srlm-io/anzhelka/hardware/pcb/QuadPower/Current/README.txt

Current:
Fixed ground plane.

To be completed:
Test REV A for other unseen problems.

REV A:
First version of the board to be approved to be milled.

Things to be fixed in:
Forget to put down a ground plane.
Forgot current limiting resistor on the DOUT pin of the MCP3208.
