srlm-io/anzhelka/doc/reports/179J_Report/quadrotor_report.tex

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

% NOTES: 
% --- Titles overlap for Engineering Effort and Societal Impacts.

% TODO: Additional material
% --- System design could be expanded (but not absolutely necessary

\documentclass{article}

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

\definecolor{lightlightgray}{gray}{0.9}

\graphicspath{{../tests/}{../figures/}{../extra/}} %\graphicspath{{path/one/}{path/two/}{path/three/}}

\fancyfoot[CO,CE]{ \thepage \\ }
\pagestyle{fancy}

\begin{document}

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

%% REV REV REV REV REV REV REV REV REV REV REV REV REV

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

%% S1 S1 S1 S1 S1 S1 S1 S1 S1 S1 S1 S1 S1 S1 S1 S1 S1 S1 S1 S1  

%% S1 S1 S1 S1 S1 S1 S1 S1 S1 S1 S1 S1 S1 S1 S1 S1 S1 S1 S1 S1  

%% S1 S1 S1 S1 S1 S1 S1 S1 S1 S1 S1 S1 S1 S1 S1 S1 S1 S1 S1 S1  
\section{Introduction}

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

%% S2 S2 S2 S2 S2 S2 S2 S2 S2 S2 S2 S2 S2 S2 S2 S2 S2 S2 S2 S2
\subsection{Executive Summary}
\begin{figure}[h!]
  \centering
	
  \caption{Rendering of the Open Source Elev-8 quadrotor platform used in the Anzhelka project (image courtesy of Parallax).}
\end{figure}  

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

Hardware on the other hand is a bit more difficult. Only one team member has any experience with designing PCBs and circuits, but not nothing to the extent of this project. We believe that, based on the work we have put into the project, that we have earned the class credits that we are receiving. Approximately 30 hours per person per week were devoted to this project(terminal program).
%% S2 S2 S2 S2 S2 S2 S2 S2 S2 S2 S2 S2 S2 S2 S2 S2 S2 S2 S2 S2

%% S2 S2 S2 S2 S2 S2 S2 S2 S2 S2 S2 S2 S2 S2 S2 S2 S2 S2 S2 S2  
\subsection{Design Objectives and System Overview}

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

\subsection{Current Project Status}
As of this writing, we still have work to do in order to achieve stable autonomous hover. We are in the process of testing the thrust torque test stand, and verifying all electrical circuits on the quadrotor. Once that is complete we will be able to write the three control loop blocks, as described in detail in the Anzhelka mathematics document \cite{anzhelka_math}. It is estimated that these blocks will be able to run at up to 300Hz (section \ref{subsec:codeperformanceestimation}).  For the project schedule, see subsection \ref{subsec:maintenance_plan_10}.

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

The project uses the following directory structure:
\begin{lstlisting}
 /hardware 
    /frame 
    /pcb 
 /software 
    /spin 
       /src 
       /lib 
       /test 
       /tool 
       /config 
    /java 
       /src 
       /lib 
       /test 
       /tool 
       /config 
 /doc 
    /datasheet 
    /reports 
    /figures 
    /notes 
    /tests 
    /extra 
 /extra 
\end{lstlisting} 

\texttt{hardware}:
Subfolders will store the major components of the project. For example, the frame has several .dxf files that are sent to the laser cutter, so that will all go into a subfolder called \texttt{frame}. The project may have several PCBs made as well, and so each should go into a subfolder under \texttt{pcb}. 

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

%\clearpage %make room for the picture

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

%%TODO: update the file path typesetting.

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

%% S1 S1 S1 S1 S1 S1 S1 S1 S1 S1 S1 S1 S1 S1 S1 S1 S1 S1 S1 S1  
\section{Requirements Specifications}
In this section we define the various requirements of the quadrotor platform. The quadrotor must be able to achieve various goals, and since it is a hard real time system the goals must be achieved by a specified deadline.
%% S1 S1 S1 S1 S1 S1 S1 S1 S1 S1 S1 S1 S1 S1 S1 S1 S1 S1 S1 S1  

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

%% S2 S2 S2 S2 S2 S2 S2 S2 S2 S2 S2 S2 S2 S2 S2 S2 S2 S2 S2 S2  

%% S2 S2 S2 S2 S2 S2 S2 S2 S2 S2 S2 S2 S2 S2 S2 S2 S2 S2 S2 S2  
\subsection{System Environment and External Interfaces}

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

%% S2 S2 S2 S2 S2 S2 S2 S2 S2 S2 S2 S2 S2 S2 S2 S2 S2 S2 S2 S2

%% S2 S2 S2 S2 S2 S2 S2 S2 S2 S2 S2 S2 S2 S2 S2 S2 S2 S2 S2 S2  
\subsection{Safety}

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

%clearpage %make room for the picture
%% S1 S1 S1 S1 S1 S1 S1 S1 S1 S1 S1 S1 S1 S1 S1 S1 S1 S1 S1 S1  
\section{System Design}
The system is fairly simple. The general system architecture consists of the central Propeller microcontroller interfacing with a number of different devices. Both hardware and software mimic this layout, which is shown below.

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

%% S1 S1 S1 S1 S1 S1 S1 S1 S1 S1 S1 S1 S1 S1 S1 S1 S1 S1 S1 S1

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

%% S1 S1 S1 S1 S1 S1 S1 S1 S1 S1 S1 S1 S1 S1 S1 S1 S1 S1 S1 S1  
\section{Software Introduction}
This section describes the quadrotor software environment.
%% S2 S2 S2 S2 S2 S2 S2 S2 S2 S2 S2 S2 S2 S2 S2 S2 S2 S2 S2 S2  
\subsection{Propeller}
For this project we selected the Parallax Propeller as our main embedded processor. This chip has several unique features that make it well suited to the real time requirments of quadrotoor flight. The Propeller is relatively inexpensive as well: \$8 per chip, plus approximately \$2 for support components.

%% S3 S3 S3 S3 S3 S3 S3 S3 S3 S3 S3 S3 S3 S3 S3 S3 S3 S3 S3 S3  
\subsubsection{Architecture}

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

%% S3 S3 S3 S3 S3 S3 S3 S3 S3 S3 S3 S3 S3 S3 S3 S3 S3 S3 S3 S3  
\subsubsection{Programming}

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

\subsection{Control Loop Frequency} \label{subsec:codeperformanceestimation}

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

%% S2 S2 S2 S2 S2 S2 S2 S2 S2 S2 S2 S2 S2 S2 S2 S2 S2 S2 S2 S2  

%% S1 S1 S1 S1 S1 S1 S1 S1 S1 S1 S1 S1 S1 S1 S1 S1 S1 S1 S1 S1  

%% S1 S1 S1 S1 S1 S1 S1 S1 S1 S1 S1 S1 S1 S1 S1 S1 S1 S1 S1 S1  
\section{Quadrotor Prototype Construction}
A quadrotor to the specifications is being constructed for this project.
%\textcolor{green}{\bf Given the relatively short duration of the class, completion of the project may not be possible; however, you must do your best to produce a working prototype that implements the most important core functionality of the system you have envisions. If graphical output is not possible, create some screen mock-ups on your own.}
%% S1 S1 S1 S1 S1 S1 S1 S1 S1 S1 S1 S1 S1 S1 S1 S1 S1 S1 S1 S1  

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

%% S2 S2 S2 S2 S2 S2 S2 S2 S2 S2 S2 S2 S2 S2 S2 S2 S2 S2 S2 S2  

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

%% S3 S3 S3 S3 S3 S3 S3 S3 S3 S3 S3 S3 S3 S3 S3 S3 S3 S3 S3 S3
\subsubsection{Motors/Propellers}

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

%% S3 S3 S3 S3 S3 S3 S3 S3 S3 S3 S3 S3 S3 S3 S3 S3 S3 S3 S3 S3

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

\begin{equation} \label{eq:motor_thrust}
K_T = \frac{T}{\rho n^2 D^4}
\end{equation}

\begin{equation} \label{eq:motor_torque}
K_Q = \frac{Q}{\rho n^2 D^5}
\end{equation}

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

%% S1 S1 S1 S1 S1 S1 S1 S1 S1 S1 S1 S1 S1 S1 S1 S1 S1 S1 S1 S1  

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

\subsection{Anzhelka Data and Command Exchange Protocol} \label{subsec:anzhelkadataandcommandexchangeprotocol}

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

Data strings are prefaced with \$ADxxx (short for Anzhelka Data type xxx). 

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

\subsubsection{Protocol String Table}
\begin{longtable}{p{2cm}p{9cm}}
\hline
\$ADRPS &
	Most recent rotations per second for each motor \newline
	Format: \newline
	\texttt{\$ADRPS m1,m2,m3,m4} \\ 
\hline
\$ADMIA &
	Most recent motor current in milliamps \newline
	Format: \newline
	\texttt{\$ADMIA m1,m2,m3,m4} \\
\hline
\$ADMVV &
	Most recent motor voltage in millivolts \newline
	Format: \newline
	\texttt{\$ADMVV m1,m2,m3,m4} \\
\hline
\$ADPWM &
	Most recent motor PWM command, in microseconds (uS) \newline 
	Format:  \newline
	\texttt{\$ADPWM m1,m2,m3,m4} \\
\hline
\$ADMKP &
	Current motor PID loop proportional constant (KP). No units.  \newline
	Format:  \newline
	\texttt{\$ADMKP m1,m2,m3,m4} \\
\hline
\$ADMKI &
	Current motor PID loop integral constant (KI). No units.  \newline
	Format:  \newline
	\texttt{\$ADMKI m1,m2,m3,m4} \\
\hline
\$ADMKD &
	Current motor PID loop derivative constant (KD). No units.  \newline
	Format:  \newline
	\texttt{\$ADMKD m1,m2,m3,m4} \\
\hline
\$ADMTH &
	Most recent motor thrust in units of Newtons.  \newline
	Format:  \newline
	\texttt{\$ADMTH m1,m2,m3,m4} \\
\hline
\$ADMTQ &
	Most recent motor torque in units of Newton-Meters.  \newline
	Format:  \newline
	\texttt{\$ADMTQ m1,m2,m3,m4} \\
\hline
\$ADDRP &
	Most recent motor rotations per second set point (the desired rps). This is the speed that motors are trying to achieve, and is fed into the motor PID loops. 
	Format: 
	\texttt{\$ADDRP m1,m2,m3,m4} \\
\hline
\end{longtable}

%% S1 S1 S1 S1 S1 S1 S1 S1 S1 S1 S1 S1 S1 S1 S1 S1 S1 S1 S1 S1  

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

%% S2 S2 S2 S2 S2 S2 S2 S2 S2 S2 S2 S2 S2 S2 S2 S2 S2 S2 S2 S2  

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

%% S1 S1 S1 S1 S1 S1 S1 S1 S1 S1 S1 S1 S1 S1 S1 S1 S1 S1 S1 S1  
\section{User Interface}
Currently, the only user interface is via the Anzhelka Terminal.
%% S2 S2 S2 S2 S2 S2 S2 S2 S2 S2 S2 S2 S2 S2 S2 S2 S2 S2 S2 S2  
\subsection{Anzhelka Terminal}
The Anzhelka project uses a PC based GUI platform called Anzhelka Terminal (AT) to display realtime system states and to allow for parameter tuning. AT is written in Python and uses the WxWidgets Python branch WxPython for the GUI. AT is cross platform.

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

%% S1 S1 S1 S1 S1 S1 S1 S1 S1 S1 S1 S1 S1 S1 S1 S1 S1 S1 S1 S1  

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

Once the PCB has been fully populated it now must be tested to ensure that all the components are in working order. One of the easiest ways to accomplish this is to develop test code that will run on the hardware and will give you a set of known outputs. Having something that will test all components several times under different inputs and outputs is key to insure that the PCB is in good working order.
%% S3 S3 S3 S3 S3 S3 S3 S3 S3 S3 S3 S3 S3 S3 S3 S3 S3 S3 S3 S3

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

%% S2 S2 S2 S2 S2 S2 S2 S2 S2 S2 S2 S2 S2 S2 S2 S2 S2 S2 S2 S2  

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

%% S1 S1 S1 S1 S1 S1 S1 S1 S1 S1 S1 S1 S1 S1 S1 S1 S1 S1 S1 S1  
\section{Engineering Effort and Societal Impacts}
Every project has an effect on other people, and autonomous quadrotors are no different.

\subsection{Realistic Constraints on Time and Money}

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

\subsection{Safety and Reliability}

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

\subsection{Ethics}

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

%% S1 S1 S1 S1 S1 S1 S1 S1 S1 S1 S1 S1 S1 S1 S1 S1 S1 S1 S1 S1  

%% S1 S1 S1 S1 S1 S1 S1 S1 S1 S1 S1 S1 S1 S1 S1 S1 S1 S1 S1 S1  
\section{Conclusions}
For this project, we have developed the hardware and software frameworks necessary to fly autonomously. We have built and tested the mechanical and electrical hardware, and developed much of the associated sensor software. We have analysed current research papers on the topic of quadrotor control, and have developed a document that clearly and precisely outlines the steps necessary to fly (\cite{anzhelka_math}). We have extensively documented the entire process, and provided all of it as open source. We have created an identity for the project in the form of the name Anzhelka and our phoenix logo. With these accomplishments we are only a few small steps away from flying.

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

%% S1 S1 S1 S1 S1 S1 S1 S1 S1 S1 S1 S1 S1 S1 S1 S1 S1 S1 S1 S1

%% S1 S1 S1 S1 S1 S1 S1 S1 S1 S1 S1 S1 S1 S1 S1 S1 S1 S1 S1 S1  
\section{References}

\begin{thebibliography}{99}

%Use postfix of 69 to indicate unknown year

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

	\bibitem{parallaxobjectexchange}
	Parallax Object Exchange \url{http://obex.parallax.com/}
\end{thebibliography}

%% S1 S1 S1 S1 S1 S1 S1 S1 S1 S1 S1 S1 S1 S1 S1 S1 S1 S1 S1 S1    

%% S1 S1 S1 S1 S1 S1 S1 S1 S1 S1 S1 S1 S1 S1 S1 S1 S1 S1 S1 S1 
\section{Acknowledgements}
We have had a considerable amount of assistance with this project. We would like to thank everyone who has supported us as we work on the largest undertaking either of us has ever done.
\begin{longtable}{l l}
W9GFO (Rich Harman)& Laser cutting of the Derlin\textregistered  \- Frame Parts \\
Gene Shermen & Machinist \\
Dale Holtkamp & Machinist \\
Elmar Palma & Workshop \\
Dr. Philip Brisk & Consulting \\
Dr. Ping Liang & Consulting \\
Dr. Roman Chomko & Consulting \\
Dr. Kastner & Consulting \\
Tom Wypych & Consulting \\
Frank Lewis & Algorithms \\
Emanuel Stingu & Algorithms \\
Texas Instraments & Samples \\
Microchip & Samples \\
Jack Mcbroom & Other \\
\end{longtable}
%% S1 S1 S1 S1 S1 S1 S1 S1 S1 S1 S1 S1 S1 S1 S1 S1 S1 S1 S1 S1 

%% S1 S1 S1 S1 S1 S1 S1 S1 S1 S1 S1 S1 S1 S1 S1 S1 S1 S1 S1 S1  
\section{Appendices}
 Include the following:

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

\end{document}
