srlm-io/anzhelka/doc/reports/presentation_2012_03_16/slides.odp

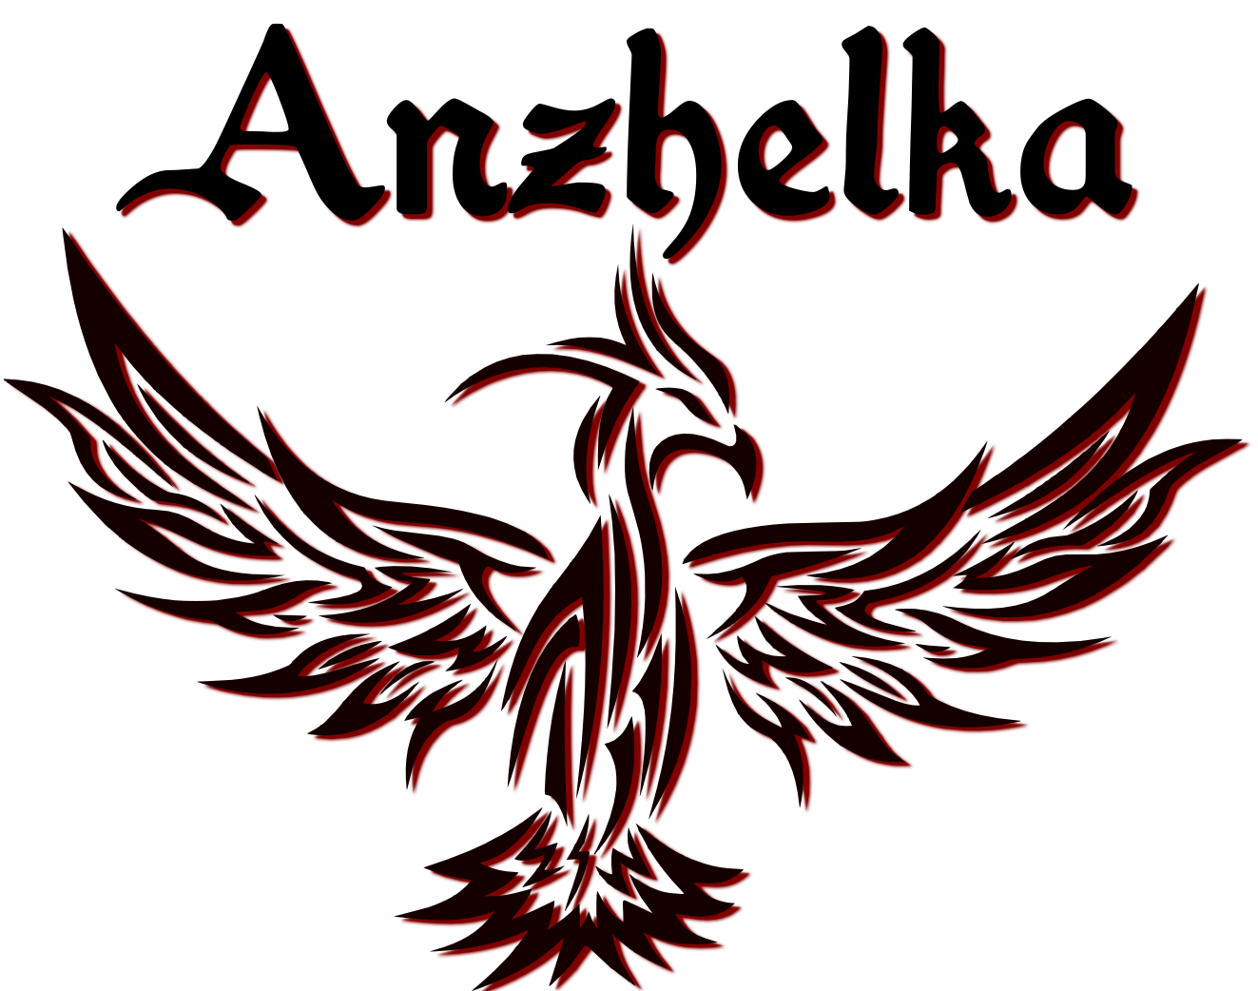
[picture p24: figure]

Luke DeRuyter ilukester@anzhelka.com

Cody Lewis srlm@anzhelka.com

## The Problem:

- It's difficult to film extreme sports
  - Mountain biking
  - Snowboarding/skiing
  - Cross country running
  - White water rafting

## Slide 4

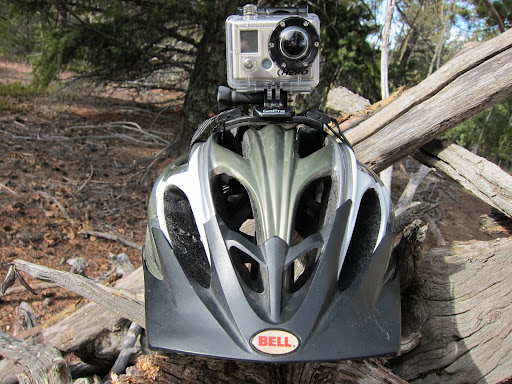
[picture p25: figure]

Helmet mounted GoPro Camera

## Slide 5

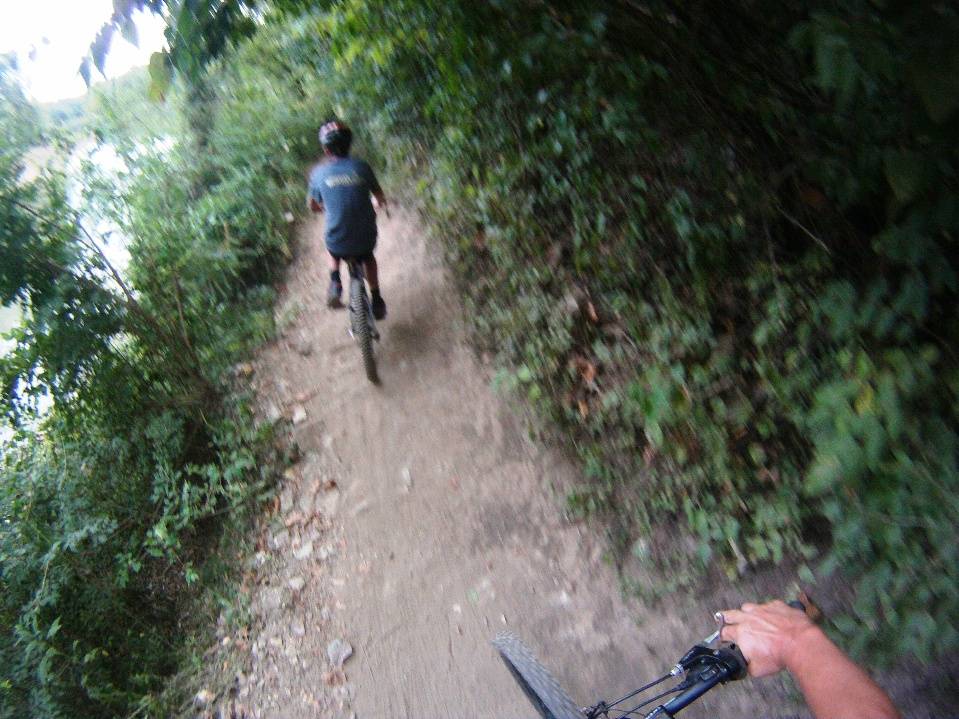
[picture p26: figure]

Note the poor focus, blurriness, and distortion

## Traditional Options

- Helmet cameras get borring fast
- Cameramen along the path are no good
- A vehicle might work...
    But is expensive

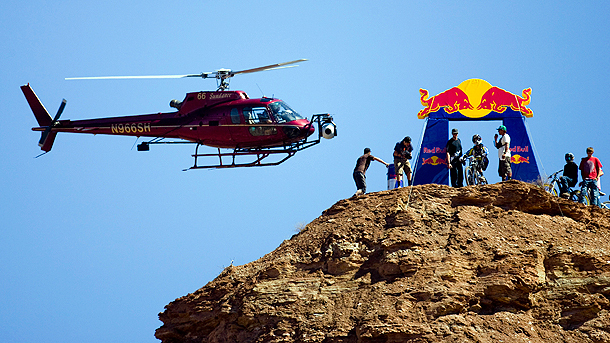
[picture p27: figure]

## Slide 7

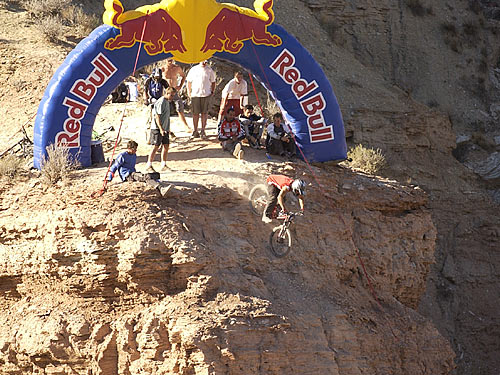
[picture p28: figure]
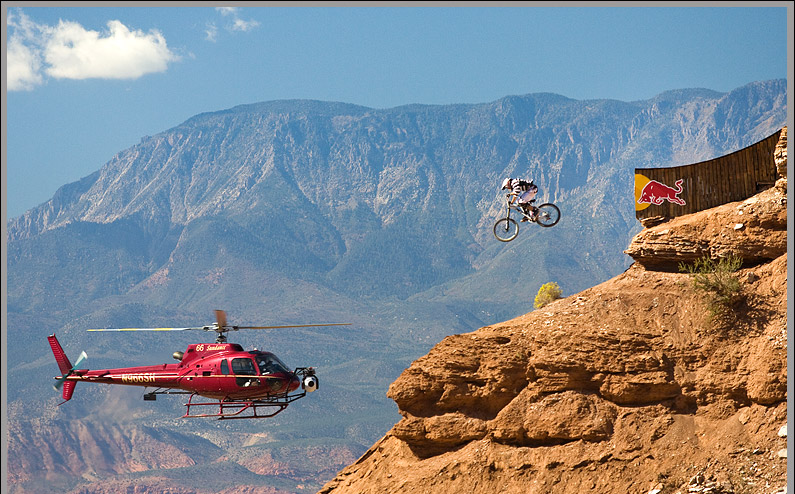
[picture p29: figure]

## Quadrotor Advantages

- A quadrotor can
  - Fly closer to the athelete
  - Operate at lower costs
  - Be more portable and available
  - Carry large payloads

## Goal

  Create a fully programmable aerial quadrotor that is autonomous, stable, and controllable

## Specifically:

  - Maintain pitch/roll/yaw to desired angle
  - Traverse to desired position
  - Carry a payload of small video camera
  - Be able to yaw/tilt payload

## Architecture

## Slide 12

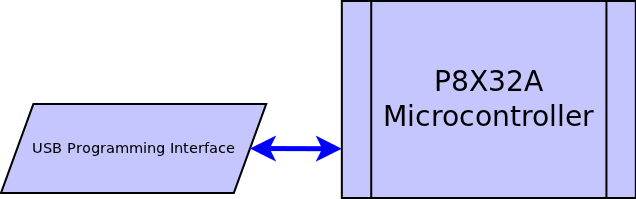
[picture p30: figure]

## Slide 13

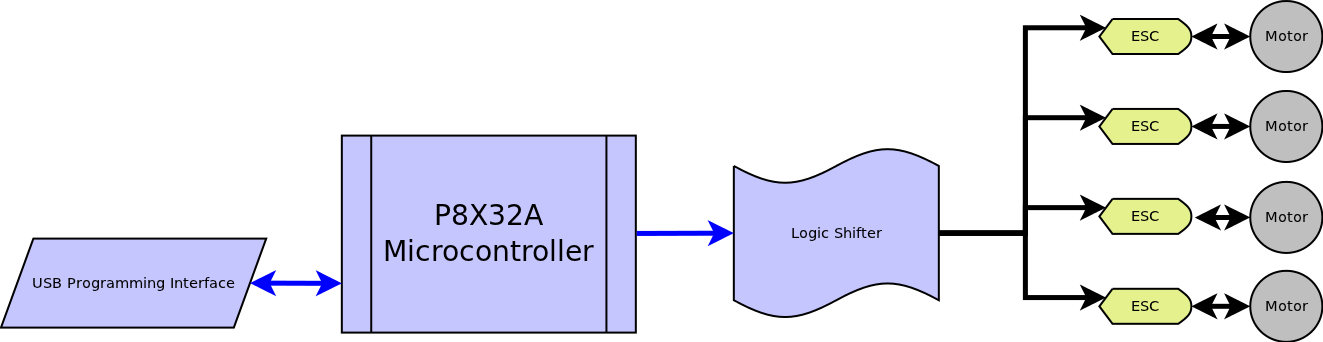
[picture p31: figure]

## Slide 14

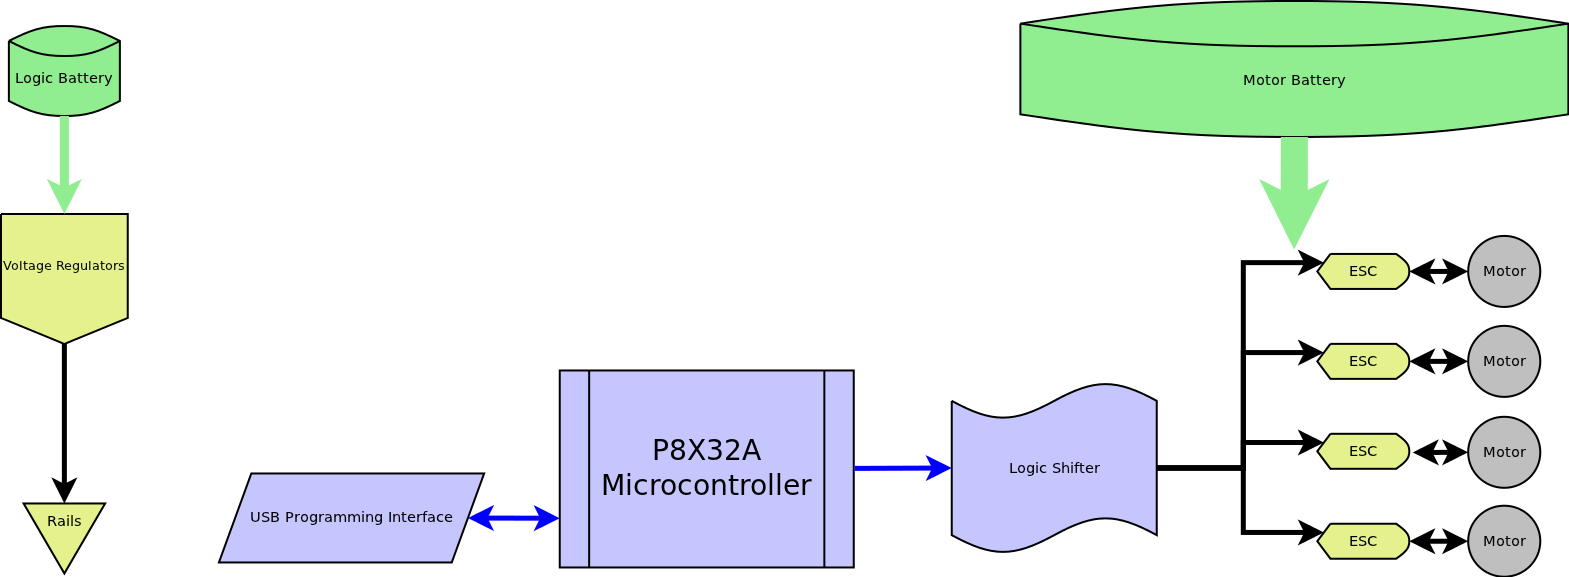
[picture p32: figure]

## Slide 15

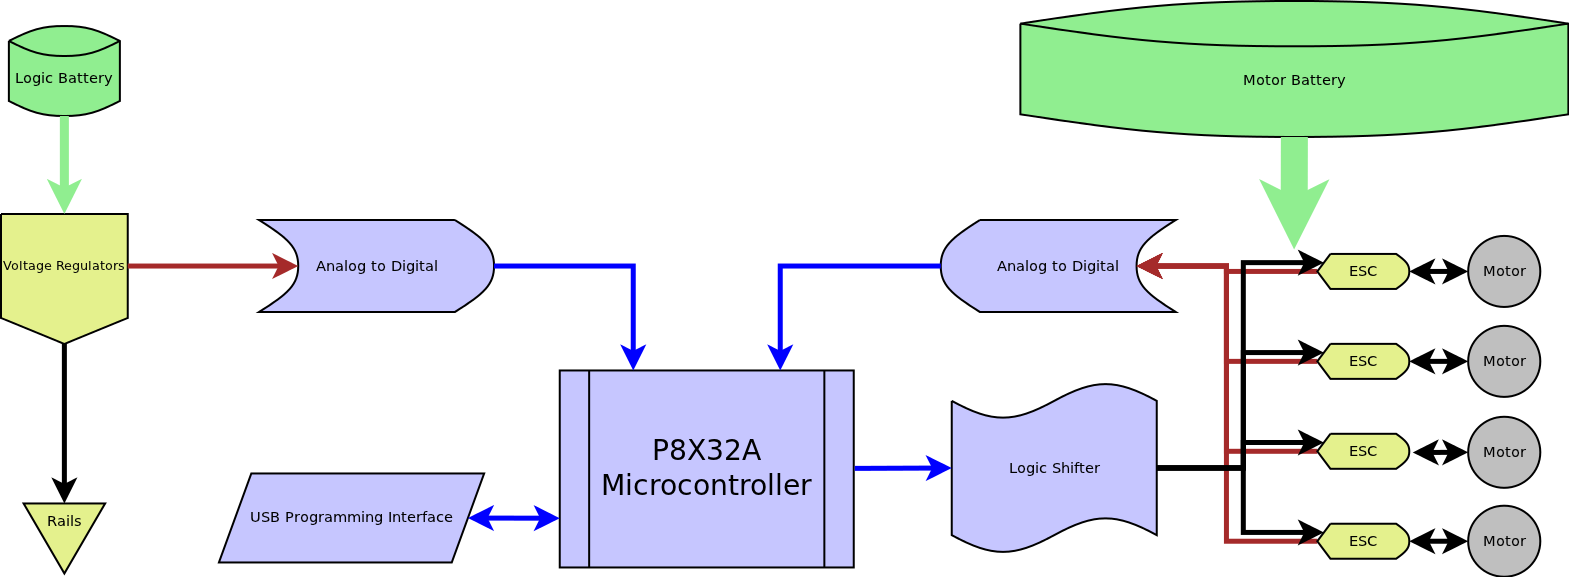
[picture p33: figure]

## Slide 16

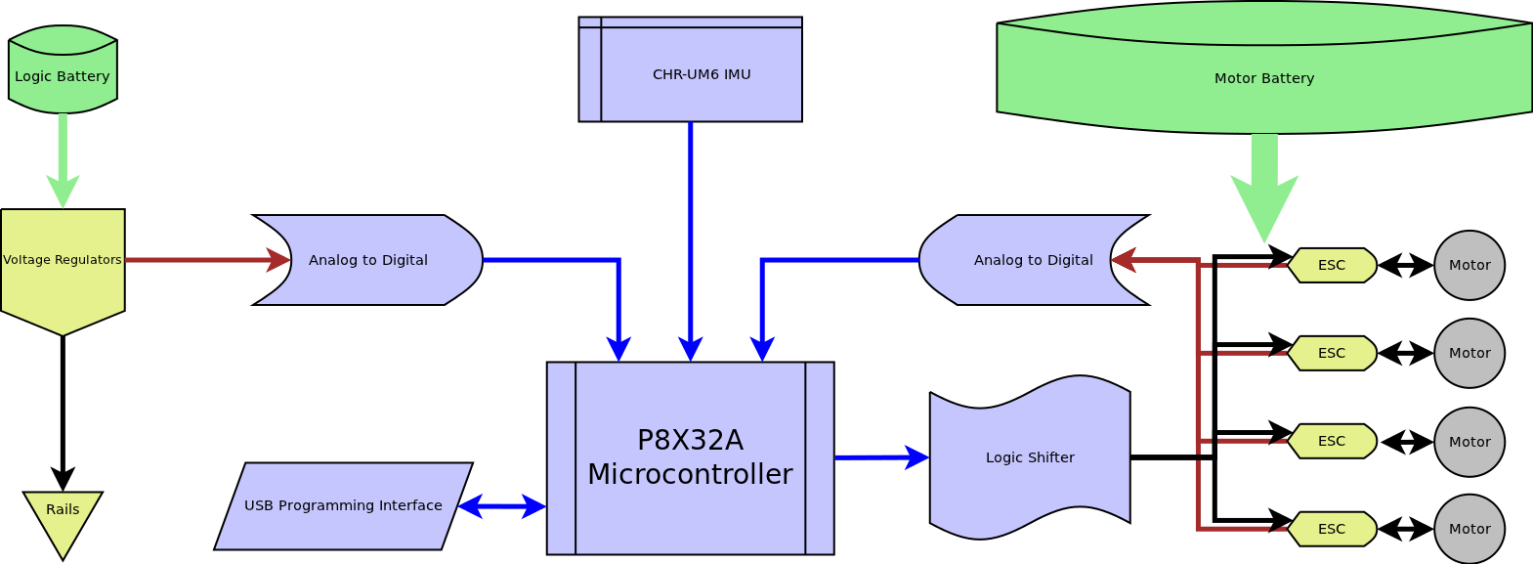
[picture p34: figure]

## Slide 17

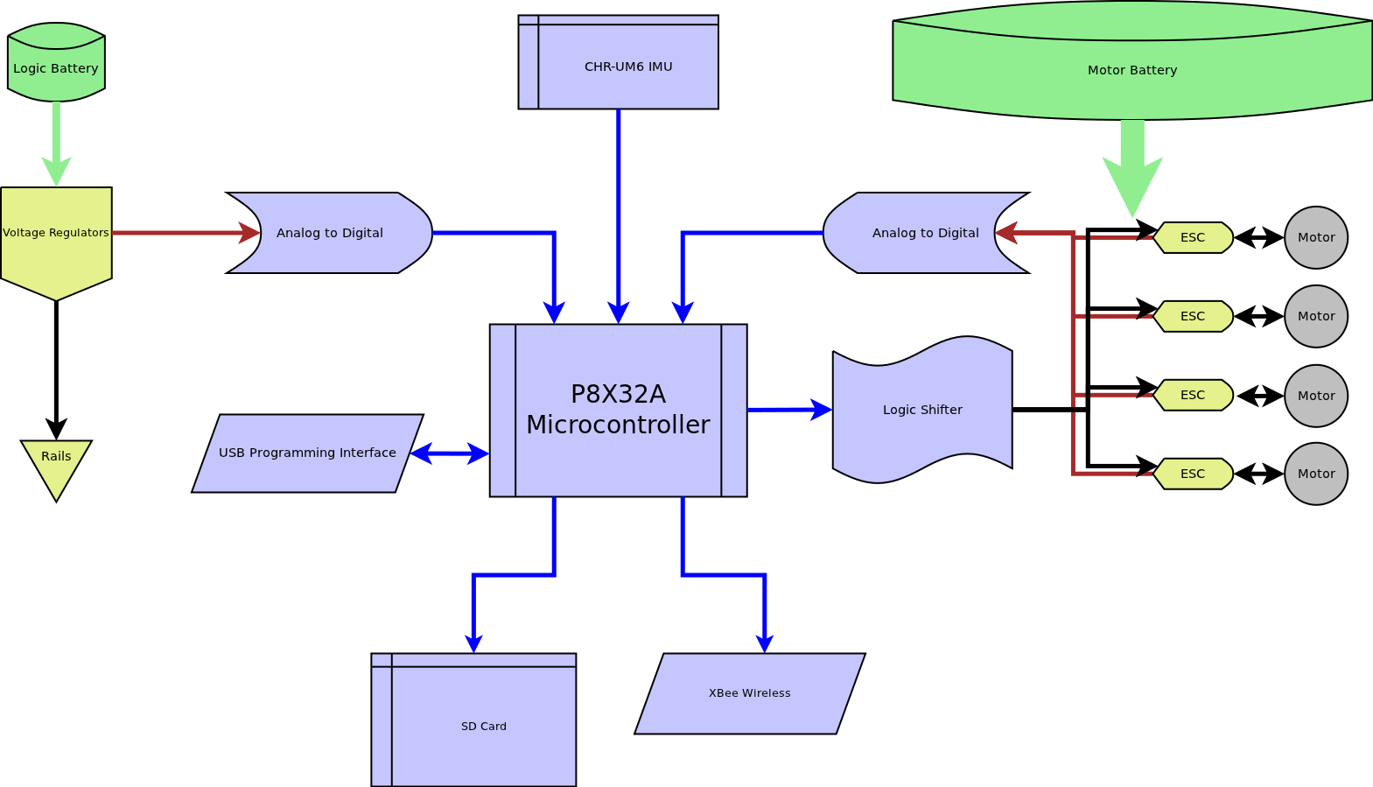
[picture p35: figure]

## Features

- Propeller Multicore Processor
- Buck regulators for 5v (x2) and 3.3v
- Level shifting for up to 24 I/O lines
- Voltage and current sensing for
  - Motors, 5v and 3.3v rails
- 8 free analog channels
- Mounting accomadations for
  - SD card, IMU, Quickstart, BoE formfactor
- Servo and I/O 3 wire headers (WRB)

## Rev A PCB


## Tasks

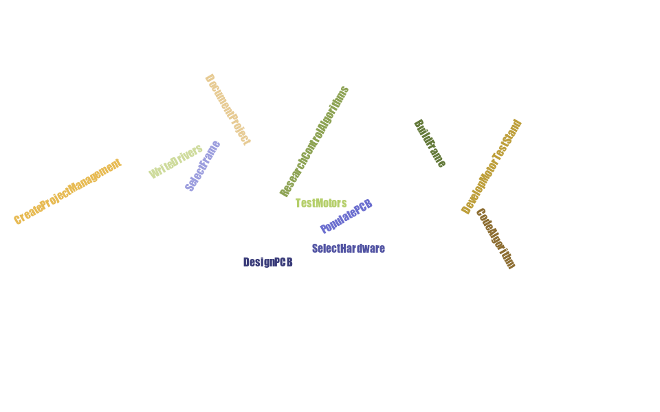
[picture p36: figure]

  Joint effort on all tasks
  No arbitrary division of labor

## Minimum Costs

Supplier | Name | Unit | Qty | Total
Parallax | Altimeter | $29.99 | 1 | $29.99
Parallax | Protoboard USB | $29.99 | 1 | $29.99
Parallax | Propeller Chip QFP | $7.99 | 1 | $7.99
Parallax | 64KB EEPROM | $1.99 | 1 | $1.99
Parallax | 5 MHz Crystal | $1.10 | 1 | $1.10
Sparkfun | Radio Modem UM96 | $44.95 | 2 | $89.90
Hobby King | 450 Outrunner Motor - Trinigy | $14.04 | 4 | $56.16
Hobby King | 30A ESC | $5.99 | 4 | $23.96
Hobby King | 3S 30C 1000mAh Battery | $8.99 | 1 | $8.99
Hobby King | 3S 30C 8000mAh Battery | $44.11 | 1 | $44.11
Hobby King | Deans XT Plugs (10 pairs) | $3.08 | 2 | $6.16
Hobby King | 12 AWG 1 meter wire BLACK | $2.49 | 3 | $7.47
Hobby King | 12 AWG 1 meter wire RED | $2.49 | 3 | $7.47
!McMaster-Carr | 5/8" Aluminum Tubing 6' | $16.38 | 1 | $16.38
!McMaster-Carr | 3/32" Delrin 24"x48" | $70.67 | 1 | $70.67
!McMaster-Carr | 1/4" Delrin 12"x12" | $27.87 | 1 | $27.87
!McMaster-Carr | 4-40 5/8" Standoff | $0.46 | 12 | $5.52
Amazon | Optima 7 RC Receiver | $58.04 | 1 | $58.04
DIY Drones | Propellers 10x4.5 1 push 1 pull | $6.00 | 2 | $12.00
Pololu | CHR-UM6-LT IMU Sensor | $149.99 | 1 | $149.99

$655.75 per quadrotor

## Test Plan

## Design Considerations

- Realistic constraints
- Industry Standards
- Time/Skills

## Summary of progress

## Technical Challenges

## Acknowledgement

## All done!
