srlm-io/anzhelka/doc/reports/quadrotor_mathematics.pdf

# Quadrotor Mathematics For Simpletons

Cody Lewis
srlm@anzhelka.com

Luke De Ruyter
ilukester@anzhelka.com

June 12, 2012

And when he [Herod] had apprehended him [Peter], he put him in prison, and delivered him to four quaternions of soldiers to keep him; intending after Easter to bring him forth to the people. –Acts 12:14, King James Bible, Cambridge Edition

Abstract
This paper describes in detail the dynamics of a quadrotor platform. Most current research papers simply explain the equations without explaining derivations or reasoning behind the numbers. This paper will explain and derive the equations for a quadrotor aircraft based an the system found in [1].

## 1 Introduction

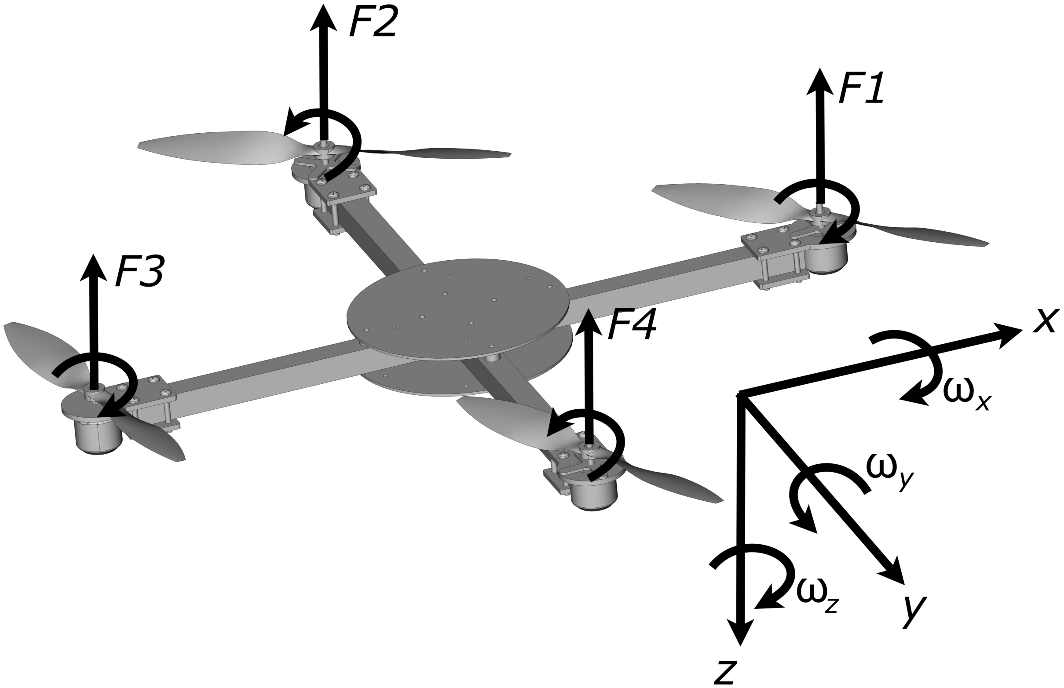
[picture p37: figure]

Figure 1: Orientation of the body axis with respect to the motor numbers and rotations.

A quadrotor is a simple aerial vehicle much like a helicopter, but instead of a single main rotor a quadrotor has four rotors. This allows for a much

1

1 INTRODUCTION

simpler mechanical system, since each rotor can be directly mounted to it’s motor without any linkages to change the pitch of a rotor.
Quadrotor dynamics are very complex. It’s difficult because you have four motors, all pointed in the same direction, and that’s it. But yet the vehicle can move on three axes in translational motion, and can rotate about another three axes. A quadrotor must be able to convert the four motor inputs into these six different (and often conflicting) motions.
The simplest case is hovering in a single location, and will be dealt with in this paper. Initially it is assumed that the quadrotor will have negligible translational motion in the global x-y plane, although eventually the translational equations may be added to this paper.
The quadrotor used in this paper is assumed to be fairly simple. The platform must be able to measure the following components:

* rotation (direction and velocity)

* translation (velocity and accleration)

* motor rotational speed

* air density

Note that if air density is assumed to be constant than performance may suffer at different altitudes or weather. In addition, the following constants must be empirically measured for each quadrotor vehicle:

* mass (kg)

* moment of inertia tensor (kg · m²
)

* offset of each rotor from the center of mass (m)

* thrust coefficient (see subsection 5.1)

* torque coefficient (see subsection 5.1)

* rotor diameter (m)

The quadrotor system is complicated by the fact that a quadrotor will need to be able to balance itself in flight. If a gust of wind blows from the side and rolls the quadrotor, it will no longer be in a stable hover. The controller will need to increase the speed of some motors and decrease the speed of others so that the vehicle is rotated back into a vertical hovering state.
There is still a problem: each motor is producing torque on the body as well as thrust. This is manifested by the motor ”attempting” to rotate the body due to the spinning mass of the motor and propeller, and the air resistance the propeller encounters. On a quadrotor frame we have two motors spinning clockwise and two spinning counter clockwise, and the torques cancel each other out. But if a motor’s speed in increased to account for a tilt, then it’s torque on the frame will increase as well, causing the whole body to rotate.

2

2.1 Variables | 2 SYMBOLS USED

And so now, when a gust of wind blows on the frame, we have to somehow correct the tilt without allowing the torque to yaw the frame. At other times we may want to yaw without tilting, and sometimes we want to do both simultaneously. There is so much more beyond just the basic thrust, tilt, and yaw: we have to account for many factors such as free stream velocity (or air, in layman’s terms) through the propellers, blade flapping, sensor failure, and the many small equations required to support the main equations.

## 2 Symbols Used

### 2.1 Variables

Variables with the subscript i denote association with motor i.

ωb | angular velocity in the body frame (rad/s)
q | attitude quaternion
q˜ | error quaternion
qd | desired quaternion
V b | velocity in the body frame (m/s)
Re | position in the inertial frame (m)
Fz | total force of the rotors on the z axis (N)
Mx − Mz | total rotor moments along each axis (N · m)
F1 − F4 | thrust force of each rotor (N)
Q | rotor torque (N · m)
T | rotor thrust force (N)
ni | rotation frequency of the rotors (Hz)
Ωi | rotation speed of the rotors (rad/s)
Ωdi | desired rotation speed of the rotors (rad/s)
Ωimeas | measured rotation speed of the rotors (rad/s)
Ωˆ
i | expected speed (rad/s)
ui | motor command (???)
ai | motor gain (no units)
ψ | yaw angle (???)
γH | tilt direction in the x-y plane (???)
αH | tilt amount around γH (???)
qV | yaw error
qH | tilt error
rx
ry
| tilt axis in the x − y plane (???)
βH | direction of the tilt axis in the x − y plane (???)
Ktilt | amount of tilt in the system? (from altitude con-
| troller)

3

3 INTRODUCTION TO QUATERNIONS

### 2.2 Constants

Inb | moment of inertia tensor (kg · m²
)
D | rotor diameter (m)
d | offset of each rotor from the center of mass (m)
ρ | air density (kg/m³
)
Kt | thrust coefficient (???)
Kq | torque coefficient (???)
Kg | the speed adaptable gain for ai (???)
fmot(·) | motor response function (???)
τ | time constant, step (???)
KPH | tilt moment proportional constant
KDH | tilt moment derivative constant
KP z | yaw moment proportional constant
KDz | yaw moment derivative constant
FP IDz | proportional altitude controller (N ?)
m | quadrotor mass (kg ?)
g | local gravity (m/s²
)
KPz | Proportional PID gain for Fz
KIz | Integral PID gain for Fz
KIz | Derivative PID gain for Fz
KPi | Motor Proportional PID gain (for 1 ≤ i ≤ 4)
KIi | Motor Integral PID gain (for 1 ≤ i ≤ 4)

## 3 Introduction to Quaternions

This paper represents orientation using quaternions. There are other methods of representing rotation, but a quaternion has several advantages that lend it well to use on the quadrotor:

* Quaternions avoid gimbal lock (where two rotation axes align on each other during the course of a rotation, producing unnatural results)

* Quaternions have smaller memory requirements (4 floats) than other representations

* Quaternions have much more efficient mathematical operations, and don’t require orthonormalization (making the axes orthogonal after an imprecise computation) like a rotation matrix does.

* Quaternions allow for smooth interpolation between two orientations.

* Orientation updates (updating a refernce orientation with ω, for example) do not require trigonometric functions.

A quaternion is a way of representing a rotation. This is similar to Euler angles, but has the advantage of a more concise notation (and math), and not

4

3 INTRODUCTION TO QUATERNIONS

having singularities like Euler angles have. Quaternions are difficult to visualize from the numbers, but are easy enough to understand and use.
A quaternion is geometrically defined as follows:

q =

q0
q1
q2
q3

=

cos (α/2)
sin (α/2) · r

This means that the rotation is around the axis r and by amount α. Note that in the second representation the second element is q1, q2, and q3 (it’s three because of the ·r, which is a three element vector). To add some terminology, the first term q0 is called the scalar part, while q1 through q3 is called the vector part.
A quaternion can be thought of a number, just like any other. So, we can do several operations such as add, multiply, invert (divide), take the norm, and of course test for equality. We’ll be focusing on rotation quaternions for the rest of this paper. A rotation quaternion is the specific form of quaternion used to represent rotation, and must have a norm equal to one. It should be noted here that a rotation quaternion is of length one (unit) only by convention and because it simplifies some proofs, but that any non-zero real multiple of q gives the the same rotation (although the interpretation of rotating by Ω about v is lost for non-unit quaternions).
We define the norm of quaternion as

kqk =

q
q

2
0 + q

2
1 + q

2
2 + q

2
3
The norm can be thought of as the ”length” of a quaternion (or vector, etc). A kqk value of 1 is called a unit quaternion. In quaternion literature there seems to be a discrepancy: some authors define the quaternion norm as above, with a square root, while others omit the square root (e.g. [3]). In this paper we will use the norm with a square root. This is called the L2-norm, or more commonly the Euclidean norm. I couldn’t find anything on a norm that squared it’s components but had no root, so we’ll ignore it (for more information on norms, see [2]).
We also define the conjugate and inverse of a rotation quaternion as

q

∗ = q

0 = (q0, −q1, −q2, −q3) = q

−1

Note this equality is only true for unit quaternions (rotation quaternions), and does not hold for other quaternions.
The only binary operation that we will be using for rotation quaternions is multiplication, denoted by ⊗. Note that quaternion multiplication is not commutative. Multiplying q1 ⊗ q2 6= q2 ⊗ q1. Multiplying rotation quaternions produces a third rotation quaternion that is the result of rotating each quaternion in reverse order starting with the right hand side quaternion. To rotate a standard vector from one coordinate system to another simply place it into

5

4 BASIC EQUATIONS

the vector part of the quaternion and set the scalar part to zero. Then, for transforming the vector re to the vector rb:
0
rb
= q

∗ ⊗

0
re
⊗ q | (3.1)
0
re
= q ⊗
0
rb
⊗ q

∗
(3.2)

(3.3)

For the rest of this paper, if a vector is rotated by a quaternion it will be written as a vector but assumed to be in the vector part of a quaternion. For example,

ω

0
b = q ⊗ ωb, where ωb =
0
ωb
(3.4)

The vector ωb is rotated by quaternion q to get the rotated vector ω

0
b
The product of two quaternions is another quaternion and is defined as:

p ⊗ q = (p0q0 − p1q1 − p2q2 − p3q3, p0q1 + p1q0 + p2q3 − p3q2, p0q2 + p2q0 + p3q1 − p1q3, p0q3 + p3q0 + p1q2 − p2q1)

(3.5)

One thing to note is that a quaternion multiplication has 12 scalar additions and 16 scalar multiplies. Since the components are floating point numbers, each quaternion multiplication consumes 28 floating point operations.

## 4 Basic Equations

In this section we will cover in detail all of the equations necessary to fly. This section explains the derivation and reasoning behind each equation used, and any assumptions that are made.

### 4.1 Roll, Pitch, and Yaw Errors

The control of a quadrotor must first consider maintaining a desired attitude. For hover, the attitude would be with no roll or pitch, and possibly some yaw. We start by generating a desired orientation qd

. This can be either a from some software routine (autonomous), or perhaps from a user control (ie, the orientation of a control board). Given the current orientation q, the quadrotor must be turned through some rotation q˜. Hence,

qd = q˜ ⊗ q | (4.1)
q˜ = qd ⊗ q
∗ | (4.2)

6

4.1 Roll, Pitch, and Yaw Errors | 4 BASIC EQUATIONS

Rewritten using the geometric definition of a quaternion,

q˜ =

cos (α/2)
sin (α/2) · re
(4.3)

Equation (4.3) says that the error quaternion is composed of an angle α and a vector re (remember, the e subscript denotes the earth reference frame). From equation (4.2) we have the value of q˜, so equation (4.3) should be rewritten as

cos (α/2)
sin (α/2) · re1
sin (α/2) · re2
sin (α/2) · re3

=

q˜0
q˜1
q˜2
q˜3

(4.4)

This puts the four known ˜qi on the right hand side and the unknown α and three rej on the left hand side. Solving, we have

α = 2 arccos ( ˜q0) | (4.5)

And, using the calculated α we solve the following:

re1 =

q˜1 sin α/2 | (4.6)

re2 =

q˜2 sin α/2 | (4.7)

re3 =

q˜3 sin α/2 | (4.8) (4.9)

The vector re is in earth coordinates, so using the properties of quaternion rotation we must rotate it into body coordinates to determine which movements are necessary.

rb = q

∗ ⊗ re ⊗ q | (4.10)
And now we can create the error quaternion in body coordinates q˜b | . Note that
α is the same as in equation (4.5). Even though the two vectors re and rb differ numerically, they are really identical except for being in different coordinate systems. So the rotation α is the same.

q˜b =

cos (α/2)
sin (α/2) · rb
| (4.11)

Instead of defining three different angles of rotation (ie, roll, pitch, and yaw) this paper will define the body rotation as tilt (encompassing both roll and pitch) and yaw. This can be written as

q˜b = qH ⊗ qV | (4.12)

7

4.2 Attitude Stabilization | 4 BASIC EQUATIONS

where qH is the tilt error and qV

is the yaw error. From the definition of the quaternion, we can rewrite (4.12) in the geometric form and expand the quaternion multiplication.

q0
q1
q2
q3

=

cos (αH/2)
sin (αH/2) · rx
sin (αH/2) · ry
sin (αH/2) · 0

⊗

cos (ψ/2)
sin (ψ/2) · 0
sin (ψ/2) · 0
sin (ψ/2) · 1

=

cos (αH/2)
sin (αH/2) · rx
sin (αH/2) · ry
0

⊗

cos (ψ/2)
0
0
sin (ψ/2) · 1

=

cos (αH/2) cos (ψ/2) − 0 − 0 − 0 0 + sin (αH/2) · rx cos (ψ/2) + sin (αH/2) · ry sin (ψ/2) + 0 0 + sin (αH/2) · ry cos (ψ/2) + 0 − sin (αH/2) · rx sin (ψ/2) cos (αH/2) sin (ψ/2) + 0 + 0 + 0

(4.13)

αH is the amount of tilt, positive by convention (note it is not the same as α in 4.11 and earlier equations). rx and ry is the tilt axis in the body x − y plane, and ψ is the yaw angle. Next, using simple algebra we can solve for the four unknowns (αH, ψ, rx, and ry) with the four knowns (qi). This gives the following four results:

αH = arccos -1 − 2

q

2
1 + q
2/2 | 0 ≤ αH < π | (4.14)
ψ = 2 arctan2 (q3, q0) | −π ≤ ψ < π | (4.15)

rx =

cos (ψ/2) q1 − sin (ψ/2) q2
sin (αH/2) | | (4.16)

ry =

sin (ψ/2) q1 − cos (ψ/2) q2
sin (αH/2) | | (4.17)

We can now find the direction of the tilt axis βH:

βH = arctan2 (ry, rx) | | (4.18)

With αH, ψ, and βH we are now have enough information to stabilize the quadrotor platform. We now turn in the next section to creating a PID control.

### 4.2 Attitude Stabilization

Attitude is controlled via a very simple PID loop. The main thing to note here is the use of βH to weight the αH term to the correct axes. The ω terms (angular rate) can be measured directly from onboard gyroscopes.

8

4.3 Altitude Stabilization | 4 BASIC EQUATIONS
Mx = KPHαH cos βH − KDHωx | (4.19)
My = KPHαH sin βH − KDHωy | (4.20)
Mz = KP zψ − KDzωz | (4.21)
| (4.22)

### 4.3 Altitude Stabilization

The current altitude can be measured in any number of ways. Many quadrotors use an ultrasonic sensor mounted on the bottom of the platform to measure distance to the ground. Alternatively, a system could use an IR sensor, altimeter module, precision differential GPS, or any system that gives a single scalar number as the altitude. This section assumes that whatever measurement was used, the current altitude can be represented a scalar number.

To stabilize the altitude, we define the altitude error as

R˜
ez = Rez − desired (Rez
) | (4.23)

Then we have a simple PID equation for the altitude:

FP IDz = KP zR˜

ez + KIzΣR˜

ez + KDz ˜˙Rez
(4.24)

In order to obtain the final force along the body z axis, equation (4.24) must be augmented with information about the weight of the quadrotor and the angle the quadrotor is tilted at:

Fz =

mg + FP IDz

Ktilt

(4.25)

Ktilt =

0 0 1
·
q ⊗

0
0
−1
- ⊗ q

∗

- (4.26)

With these equations, the more the body is tilted the Fz will become and the faster the quadrotor will move in the x − y plane, without a mathematical bound. In reality, at some point the motors will become saturated (running at maximum speed) and the quadrotor will not be able to simultaneously maintain a commanded altitude and attitude.

### 4.4 Forces to Motor Speeds

In previous sections we have calculated the desired moments Mx, My, and Mz, and the desired force Fz. In this section we will take those moments and convert it to the desired rotation speed of each motor.

9

4.4 Forces to Motor Speeds | 4 BASIC EQUATIONS

First, in equation (4.27) we have a standard conversion from rotational frequency to angular frequency .

Ωi = 2πni | (4.27)

Each motor generates a thrust in the direction of the motor shaft axis, and a torque around the motor shaft axis. The calculation of KT and KQ is discussed in subsection 5.1.

T = KT ρn²D⁴
(4.28)

Q = KQρn²D⁵
(4.29)

These two equations are used to define T and Q. The constants KT and KQ are determined experimentally. A motor test stand must be able to measure T, Q, ρ, n, and D, and generate the constants for a particular motor and propeller combination. Note the exponents in the equations: rotational speed and propeller diameter have a significant effect on the thrust and torque.

For use onboard the quadrotor, equation (4.28) will be used with equation (4.27) to connect thrust to rotational speed. This derivation is done in equation (4.30). By this combination we will be able to determine what rotational speed we need to run the motors at to achieve a specified thrust. From equations (4.28) and
(4.27) we rewrite and combine:

n

2 =

T
ρKT D⁴

n =

1
D²

s
T
ρKT

Ωdi = 2πn

Ωdi =

2π
D²

s
T
ρKT

(4.30)

With equation (4.30) we have an equation that will tie the thrust required to how fast the rotors must spin. This can later be fed into a PI controller for each motor, described in section 4.5 .

Finally, we need to determine what the thrust and torque of each motor for the given M and Fz:

10

4.5 Motor control | 4 BASIC EQUATIONS

Fz
Mx
My
Mz

=

1 | 1 | 1 | 1
0 | −d 0 | d
−d | 0 | d | 0
c | −c | c −c

·

F1
F2
F3
F4

(4.31)

1 | 1 | 1 | 1
0 | −d 0 | d
−d | 0 | d | 0
c | −c | c −c

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
(4.32)

(4.33)

where
c =

KQD
KT

(4.34)

Solving the matrix inversion and multiplication, we arrive at the final four equations:

F1 = +

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
(4.35)

F2 = −

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
(4.36)

F3 = +

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
(4.37)

F4 = −

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
(4.38)

(4.39)

Now, we have the force (thrust) that each motor must produce in order to maintain the desired heading, and can use equation (4.30) to determine the desired rotor speed.

### 4.5 Motor control

This subsection describes the equations used to set the rotational speed of the motors. Note that this differs from [1]: in that paper the authors used an empirically measured function (fmot) to estimate the rotational speed based on the voltage of the motor and the command given. This required a dynamically adjustable constant ai to calibrate each motor for small differences in manufacturing. In this paper it is assumed that actual motor rotational speed is able to be measured. By measuring the rotational speed of the motors we are able to ignore the manufacturing differences between motors, and create a closed loop control. If a motor is not spinning at the correct speed the PI control loop described next will be able to correct until the desired rotation is achieved.

11

4.6 Quadrotor Motion Model | 4 BASIC EQUATIONS

The following two equations are explicitly defined a discrete time t. For clarity, the subscript i denoting a specific motor is implied but not written:

Ω (t)

Ierror = Ω (t − 1)Ierror + (Ωd − Ωi) | (4.40)

ui = KP (Ωd − Ωi) + KIΩ (t)

Ierror | (4.41)

### 4.6 Quadrotor Motion Model

The equations in this section describe the motion of the quadrotor body through space. In essence, these equations are taken directly from any introductory physics textbook and simply expanded a small amount. These equations are necessary for translational motion, but are not required to simply hover

V˙
b =

1
m

0
0
Fz
- + q

∗ ⊗

0
0
g
- ⊗ q − ωb × V b | (4.42)

Equation (4.42) describes the body acceleration of the quadrotor. The equation follows the form of F = ma from traditional physics (rewritten for a =

F
m ). The
first accounts for the acceleration due to the force of the motors. The second term accounts for the acceleration due to gravity, rotated based on the vehicle orientation. The third term accounts for fictitious forces (forces due to the non-inertial reference frame of the body).

ω˙ b = I

−1
nb

Mx
My
Mz

- − ωb × (Inbωb)
- (4.43)

Equation (4.43) describes the angular acceleration of the quadrotor. The equation follows the form of τ = Iα from traditional physics (rewritten for α =

τ
I
The first term (with the moments Mxyz) accounts for the rotational force of the propellers. The second term accounts for the fictitious forces.

R˙
e = q ⊗ V b ⊗ q

∗
(4.44)

Equation (4.44) relates velocity in the body reference frame to velocity in the earth reference frame.

q˙ =

1
2
q ⊗ ωb | (4.45)

Note that equation (4.45) describes the derivative of a quaternion.

12

5 IMPLEMENTATION DETAILS


Figure 2: The Elev-8 quadrotor frame.

## 5 Implementation Details

This section describes all the equations necessary to have a stable hovering platform, and their order of implementation. It is broken down into three logical blocks: moment calculations (5.2), z axis force calculations (5.3), and motor speed calculations (5.4).

It is assumed that all math is done with floating point operations, and that the variables ti are temporary variables that can be used to hold a value for a short duration of time.

### 5.1 Thrust and Torque Coefficient Measurements

In the equations to calculate the thrust (4.28) and torque (4.29) of each motor we have two constants, KT and KQ that need to be measured empirically. The two equations are reproduced below:

KT =

T
ρn²D⁴

(5.1)

KQ =

Q
ρn²D⁵

(5.2)

Our test stand must be able measure thrust, torque, rotational speed, rotor diameter, and air density.

13

5.2 Moment Calculations | 5 IMPLEMENTATION DETAILS

### 5.2 Moment Calculations

This subsection calculates the moments Mx, My, and Mz from the current orientation q and the desired orientation qd

. The full derivation can be found in sections 4.1 and 4.2.

Input variables:

ωb | angular velocity in the body frame (rad/s)
q | attitude quaternion
qd | desired quaternion

Input constants:

KPH | tilt moment proportional constant
KDH | tilt moment derivative constant
KP z | yaw moment proportional constant
KDz | yaw moment derivative constant
Output: Mx − Mz | total rotor moments along each axis (N · m)

q˜ = qd ⊗ q

∗
(5.3)
α = 2 arccos ( ˜q0) | (5.4)
t1 = sin α/2 | (5.5)

re1 =

q˜1 t1 | (5.6)

re2 =

q˜2 t1 | (5.7)

re3 =

q˜3 t1 | (5.8)

rb = q

∗ ⊗ re ⊗ q | (5.9)

q˜b =

cos (α/2)
sin (α/2) · rb
| (5.10)

αH = arccos -1 − 2

q

2
1 + q
2/2 | (5.11)
ψ = 2 arctan2 (q3, q0) | (5.12)
t1 = cos (ψ/2) | (5.13)
t2 = sin (ψ/2) | (5.14)
t3 = sin (αH/2) | (5.15)

rx =

t1q1 − t2q2 t3 | (5.16)

ry =

t2q1 − t1q2 t3 | (5.17)
βH = arctan2 (ry, rx) | (5.18)
Mx = KPHαH cos βH − KDHωx | (5.19)
My = KPHαH sin βH − KDHωy | (5.20)

14

5.3 Z Axis Force Calculations | 5 IMPLEMENTATION DETAILS
Mz = KP zψ − KDzωz | (5.21)

### 5.3 Z Axis Force Calculations

This subsection calculates the necessary total thrust along the quadrotor z axis. This section takes the desired altitude and the current orientation and outputs the resultant Fz necessary. The relevant equation derivations can be found in section 4.3.

Input variables:

q | attitude quaternion
Rez | position in the inertial frame (m)
Fz | total force of the rotors on the z axis (N)
desired (Rez

) Desired z position (altitude) (m)

Input Constants:

m | quadrotor mass (kg ?)
g | local gravity (m/s²
)
KPz | Proportional PID gain for Fz
KIz | Integral PID gain for Fz
KIz | Derivative PID gain for Fz
Output Variables: Fz | total force of the rotors on the z axis (N)

Ktilt =

0 0 1
·
q ⊗

0
0
−1
- ⊗ q

∗

- (5.22)

R˜
ez = Rez − desired (Rez
) | (5.23)

FP IDz = KP zR˜

ez + KIzΣR˜

ez + KDz ˜˙Rez | (5.24)

Fz =

mg + FP IDz

Ktilt

| (5.25)

15

5.4 Motor Speed Calculations | 5 IMPLEMENTATION DETAILS

### 5.4 Motor Speed Calculations

This subsection calculates the output command (i.e. motor speed) for each of the motors. The derivations for these equations can be found in sections 4.4 and 4.5.

Input variables:

Fz | total force of the rotors on the z axis (N)
Mx, My, Mz | total rotor moments along each axis (N · m)
nimeas | rotation frequency of the rotors (Hz)

Input Constants:

D | rotor diameter (m)
d | offset of each rotor from the center of mass (m)
ρ | air density (kg/m³
)
Kt | thrust coefficient
Kq | torque coefficient
KPi | Motor Proportional PID gain (for 1 ≤ i ≤ 4)
KIi | Motor Integral PID gain (for 1 ≤ i ≤ 4)
π | pi
Output Variables: ui | motor command

c =

KQD
KT

(5.26)

t1 =

Mz
4c

(5.27)

t2 =

My
2d

(5.28)

t3 =

Mx
2d

(5.29)

t4 =

Fz
4

(5.30)

F1 = +t1 − t2 + t4 | (5.31)
F2 = −t1 − t3 + t4 | (5.32)
F3 = +t1 + t2 + t4 | (5.33)
F4 = −t1 + t3 + t4 | (5.34)

t1 =

2π D² | (5.35)
t2 = ρKT | (5.36)

Ωd1 = t1

p
F1/t2 | (5.37)

Ωd2 = t1

p
F2/t2 | (5.38)

Ωd3 = t1

p
F3/t2 | (5.39)

Ωd4 = t1

p
F4/t2 | (5.40)
Ω (t)
Ierror1 = Ω (t − 1)Ierror1 + (Ωd1 − Ωi1) | (5.41)

16

6 BASIC EQUATIONS FROM [?]

Ω (t)

Ierror2 = Ω (t − 1)Ierror2 + (Ωd2 − Ωi2) | (5.42)
Ω (t)
Ierror3 = Ω (t − 1)Ierror3 + (Ωd3 − Ωi3) | (5.43)
Ω (t)
Ierror4 = Ω (t − 1)Ierror4 + (Ωd4 − Ωi4) | (5.44)
u1 = KP 1 (Ωd1 − Ωi1) + KI1Ω (t)
Ierror1

(5.45)
u2 = KP 2 (Ωd2 − Ωi2) + KI2Ω (t)
Ierror2

(5.46)
u3 = KP 3 (Ωd3 − Ωi3) + KI3Ω (t)
Ierror3

(5.47)
u4 = KP 4 (Ωd4 − Ωi4) + KI4Ω (t)
Ierror4

(5.48)

From here, we are able to send the command ui to the motor ESCs via a standard PWM signal. Note that the ui will have to be adjusted to fit within the standard servo type PWM signal standard. Typically, this means that the signal is set so that a motor speed of 0 corresponds to 1000uS, and a full motor speed corresponds to 2000uS, with a pulse every 20mS (approximately).

## 6 Basic Equations from [1]

The follow equations are exactly as written in [1]. The equations in previous sections follow the general guidelines of these equations, but some exceptions were made. They are here for reference only.

### 6.1 Quadrotor Model

V˙
b =

1
m

0
0
Fz
- + q

∗ ⊗

0
0
g
- ⊗ q − ωb × V b | (6.1)

ω˙ b = I

−1
nb

Mx
My
Mz

- − ωb × (Inbωb)
- (6.2)

R˙
e = q ⊗ V b ⊗ q

∗
(6.3)

q˙ =

1
2
q ⊗ ωb | (6.4)

KT =

T
ρn²D⁴

(6.5)

KQ =

Q
ρn²D⁵

(6.6)

Ωi = 2πni | (6.7)

17

6.2 Motor Gain Estimation | 6 BASIC EQUATIONS FROM [?]

τΩ˙
i + Ωi = aifmot (ui
, Vbatt) | (6.8)

Fz
Mx
My
Mz

=

1 | 1 | 1 | 1
0 | −d 0 | d
−d | 0 | d | 0
c | −c | c −c

·

F1
F2
F3
F4

(6.9)

where
c =

KQD
KT

(6.10)

Ωdi =

2π
D²

s
−Fdi
KT ρ

(6.11)

ui = f

−1

mot
1
ai

Ωdi, Vbatt
(6.12)

### 6.2 Motor Gain Estimation

a˙ i = Kg

Ωimeas − Ωˆ
i
(6.13)

### 6.3 Yaw and Tilt Errors

qd = q˜ ⊗ q | (6.14)
q˜ = qd ⊗ q
∗ | (6.15)

q˜ =

cos (α/2)
sin (α/2) · re
(6.16)

rb = q

∗ ⊗ re ⊗ q | (6.17)

q˜b =

cos (α/2)
sin (α/2) · rb
(6.18)

q˜b = qH ⊗ qV

(6.19)

q0
q1
q2
q3

=

cos (αH/2)
sin (αH/2) · rx
sin (αH/2) · ry
sin (αH/2) · 0

⊗

cos (ψ/2)
sin (ψ/2) · 0
sin (ψ/2) · 0
sin (ψ/2) · 1

(6.20)

αH = arccos -1 − 2

q

2
1 + q
2/2 | 0 ≤ αH < π | (6.21)
ψ = 2 arctan2 (q3, q0) | − π ≤ ψ < π | (6.22)

18

6.4 Attitude stabilization | REFERENCES

rx =

cos (ψ/2) q1 − sin (ψ/2) q2
sin (αH/2) | (6.23)

ry =

sin (ψ/2) q1 − cos (ψ/2) q2
sin (αH/2) | (6.24)
βH = arctan2 (ry, rx) | (6.25)
γH = arctan2 (rx, ry) | (6.26)

### 6.4 Attitude stabilization

Mx = KPHαH cos βH − KDHωx | (6.27)
My = KPHαH sin βH − KDHωy | (6.28)
Mz = KP zψ − KDzωz | (6.29)
| (6.30)

### 6.5 Altitude Control

Fz =

mg + FP IDz Ktilt | (6.31)

Ktilt =

0 0 1
·
q ⊗

0
0
−1
- ⊗ q

∗

- (6.32)

## References

[1] E. Stingu, F. Lewis, ”Design and Implementation of a Structured Flight Controller for a 6DoF Quadrotor Using Quaternions,” Mediterranean Conference on Control & Automation, pp. 1233-1238, June 2009.
[2] M. Malek, ”Vector and Matrix Norms”, California State University, East Bay, May 2009.
[3] K. Shoemake, ”Quaternions”, Department of Computer and Information Science, University of Pennsylvania.

19
