srlm-io/anzhelka/doc/figures/code_anzhelka_com_screenshot.png

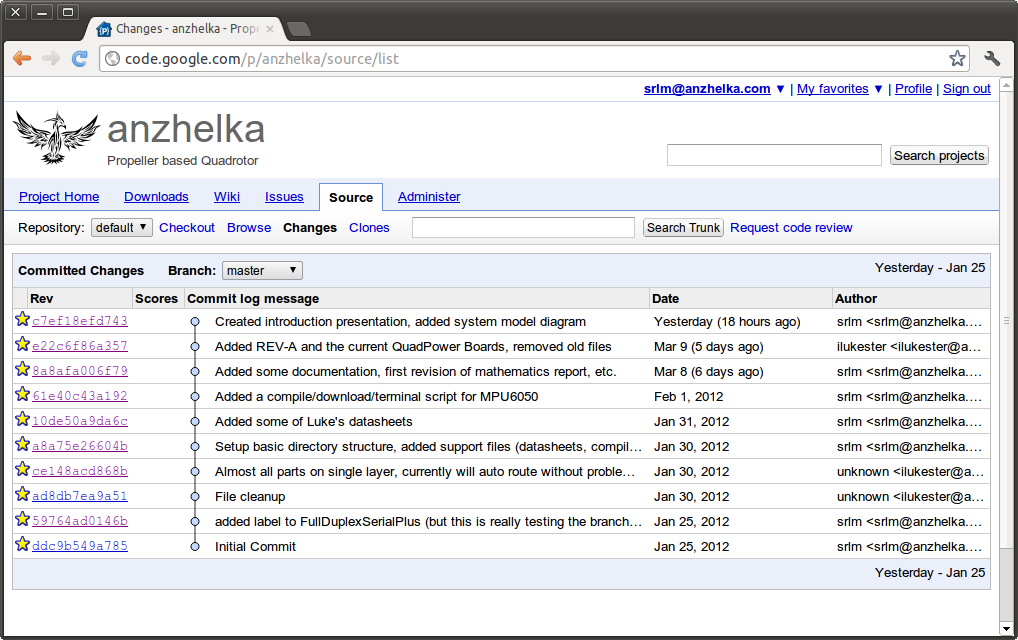
doc/figures/code_anzhelka_com_screenshot.png
