srlm-io/anzhelka/doc/figures/control_loop_flow.png

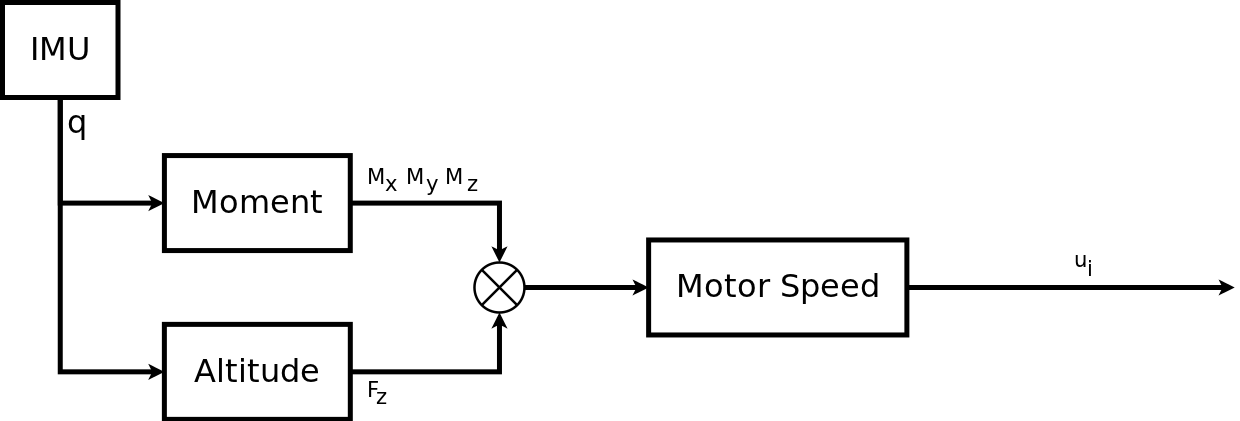
doc/figures/control_loop_flow.png
