srlm-io/anzhelka/doc/figures/editorial/2922131722_86888f3df5_o.jpg

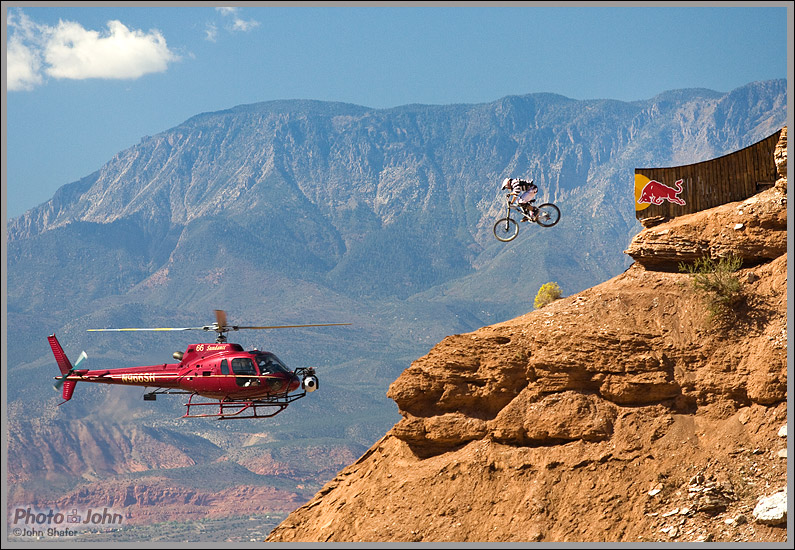
doc/figures/editorial/2922131722_86888f3df5_o.jpg
