srlm-io/anzhelka/doc/figures/equations/block_altitude.png

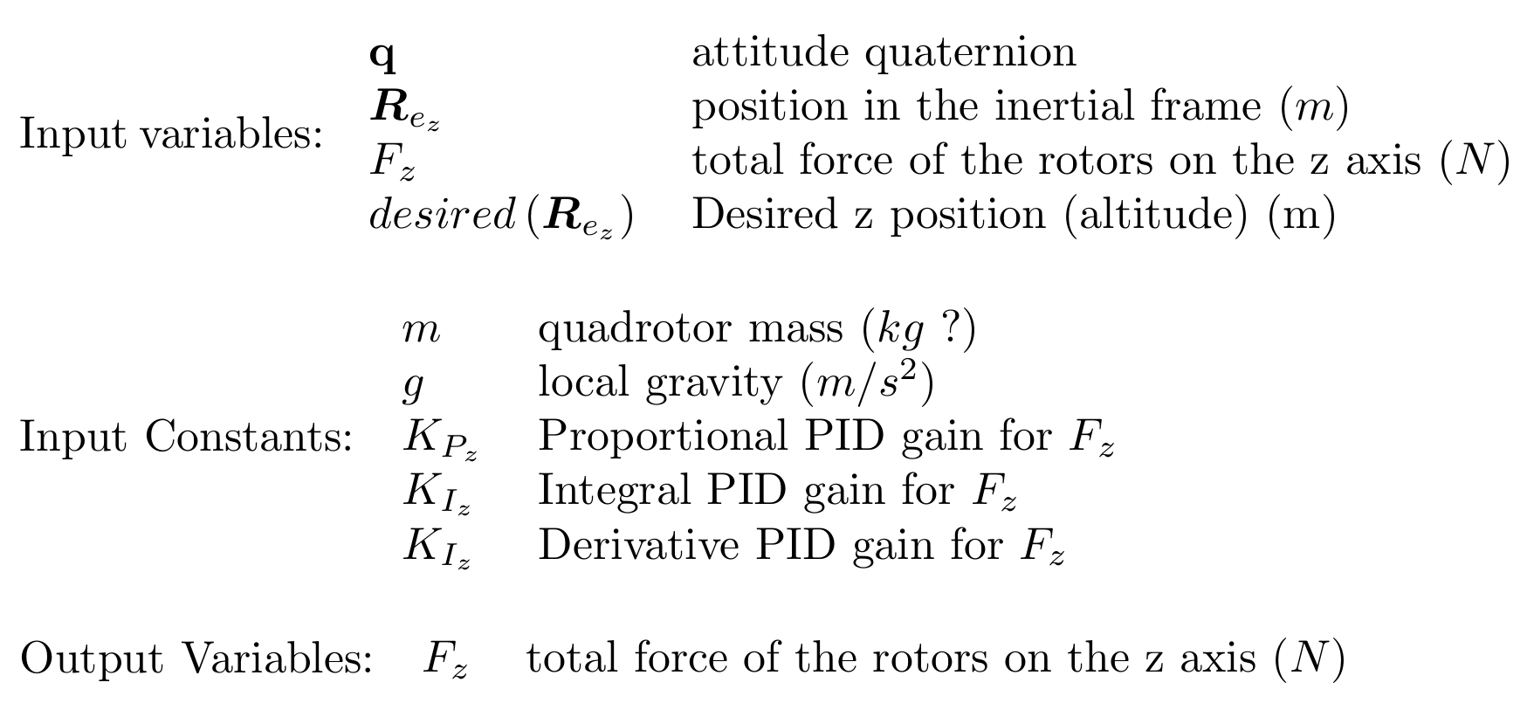
doc/figures/equations/block_altitude.png
