srlm-io/anzhelka/doc/figures/equations/block_moment.png

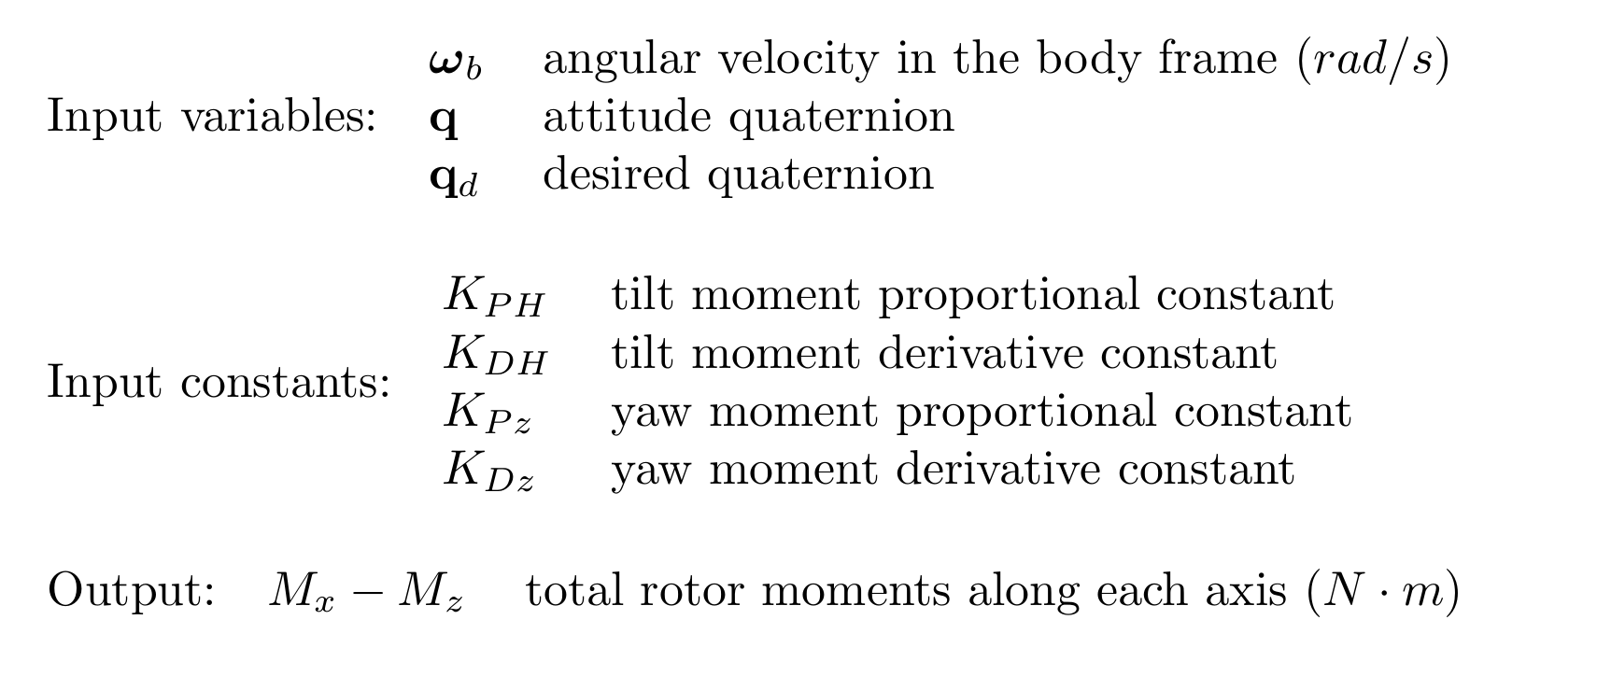
doc/figures/equations/block_moment.png
