srlm-io/anzhelka/doc/figures/equations/block_motor.png

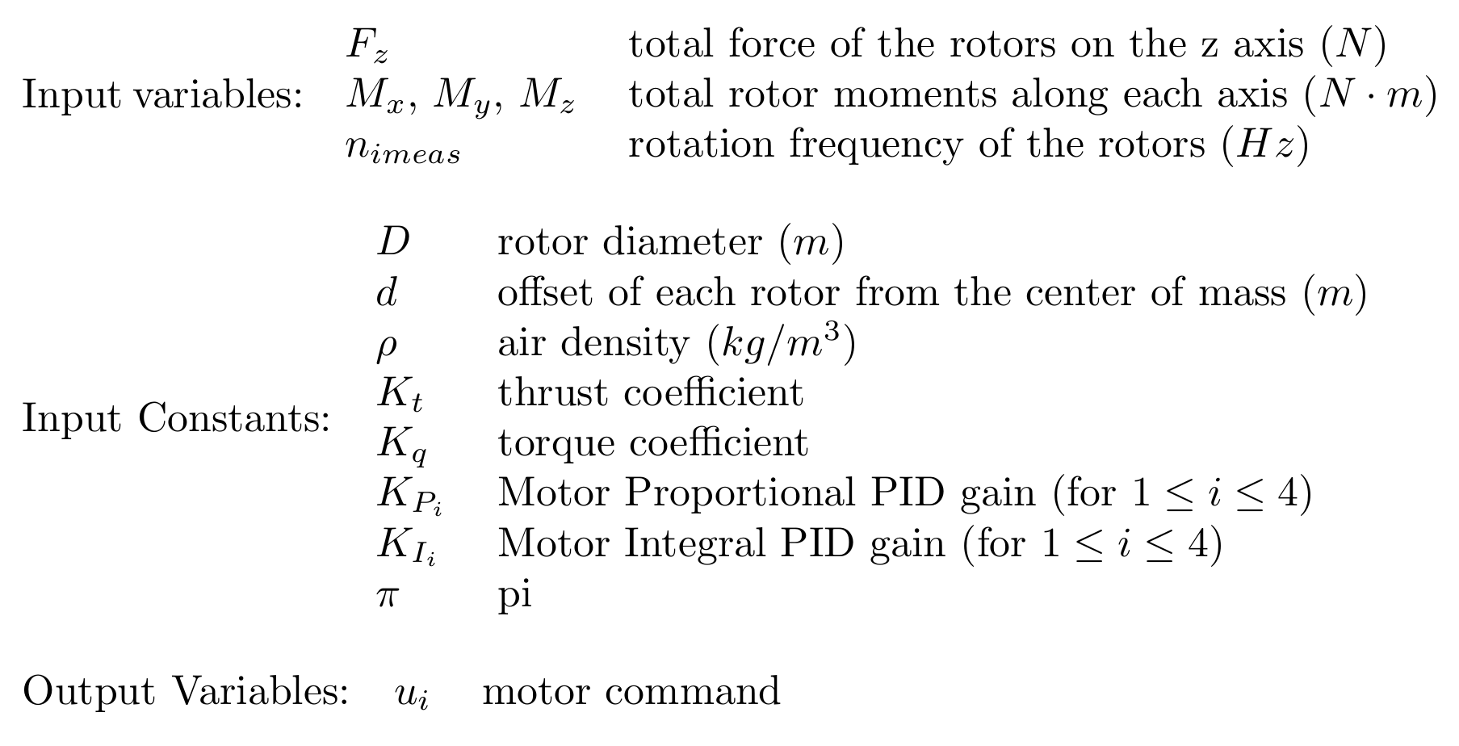
doc/figures/equations/block_motor.png
