srlm-io/anzhelka/doc/figures/equations/control_matrix.png

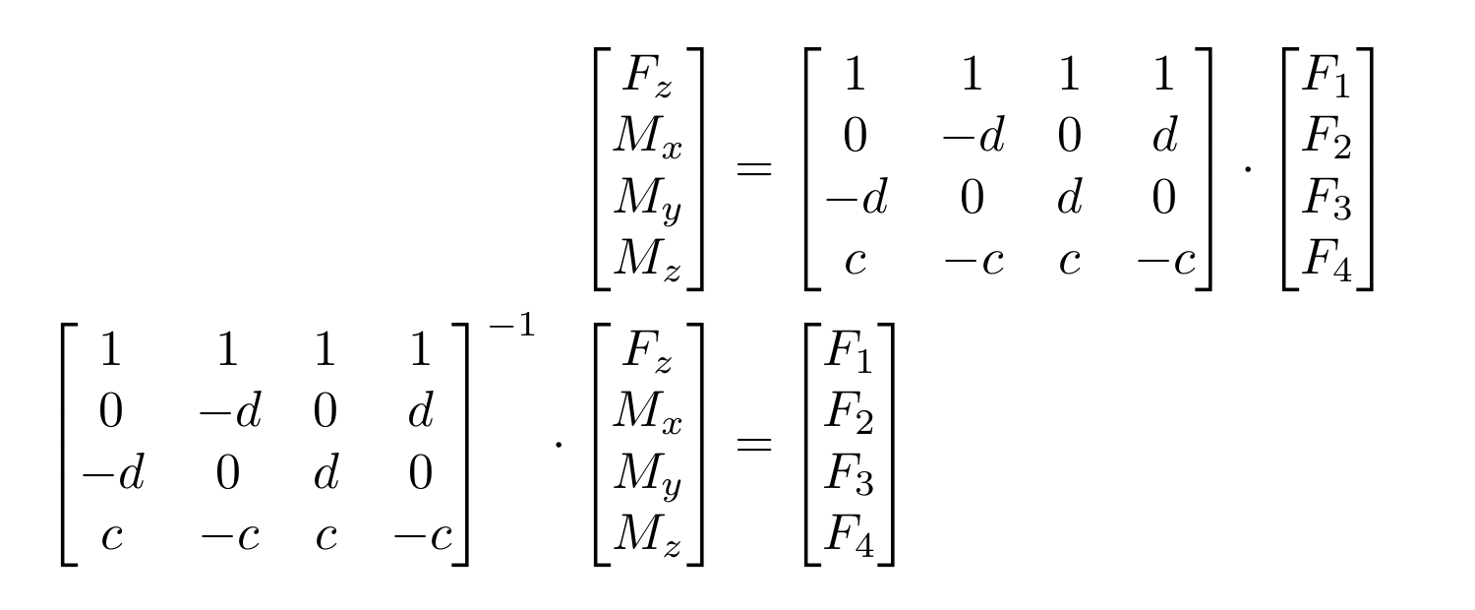
doc/figures/equations/control_matrix.png
