srlm-io/anzhelka/doc/figures/equations/control_matrix_simplified.png

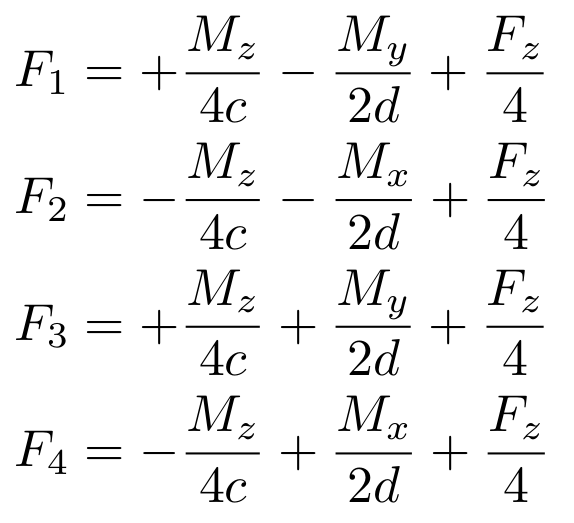
doc/figures/equations/control_matrix_simplified.png
