srlm-io/anzhelka/doc/figures/equations/fma.png

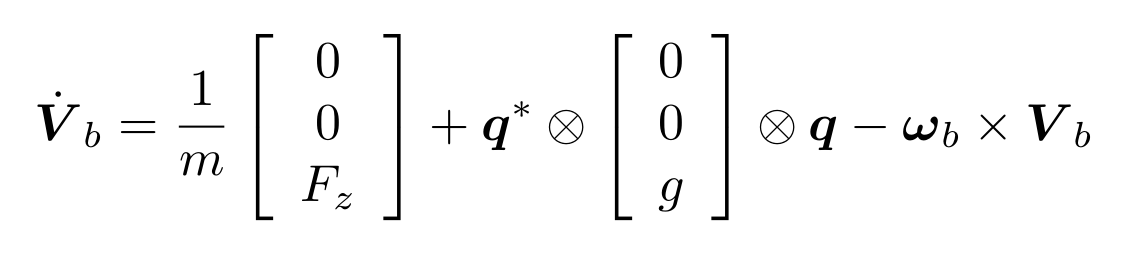
doc/figures/equations/fma.png
