srlm-io/anzhelka/doc/figures/equations/fma_rot.png

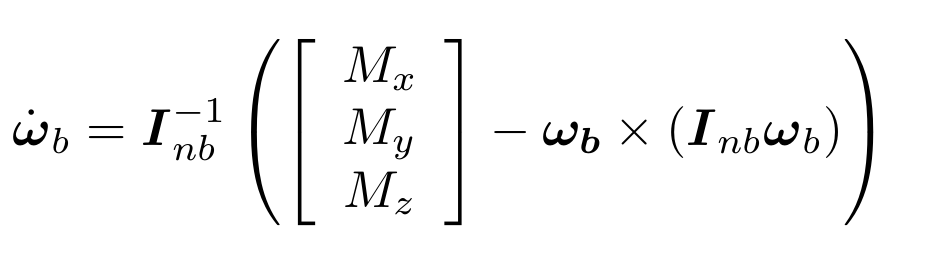
doc/figures/equations/fma_rot.png
