srlm-io/anzhelka/doc/figures/equations/force_to_rotational_speed.png

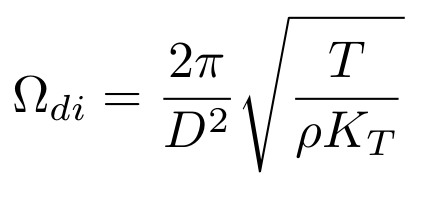
doc/figures/equations/force_to_rotational_speed.png
