srlm-io/anzhelka/doc/figures/equations/force_z.png

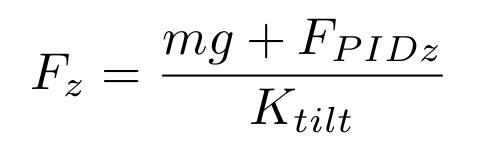
doc/figures/equations/force_z.png
