srlm-io/anzhelka/doc/figures/equations/list_altitude.png

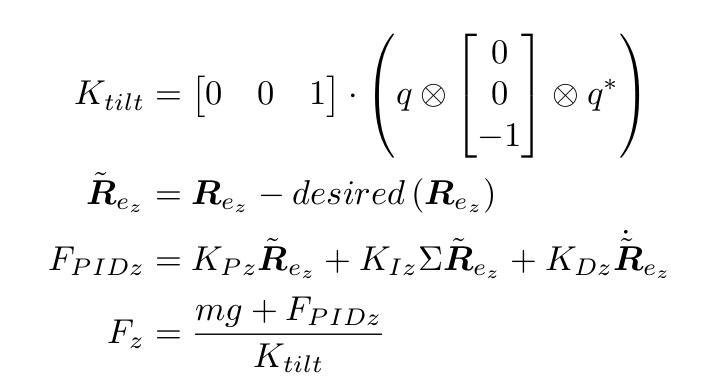
doc/figures/equations/list_altitude.png
