srlm-io/anzhelka/doc/figures/equations/list_moment.png

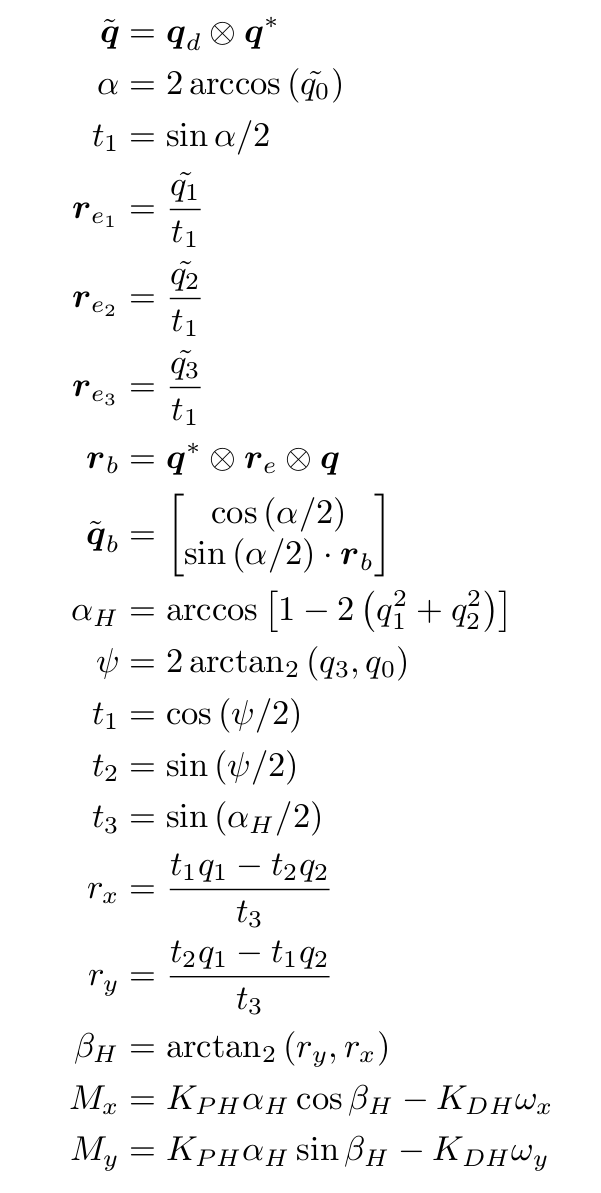
doc/figures/equations/list_moment.png
