srlm-io/anzhelka/doc/figures/equations/list_motor.png

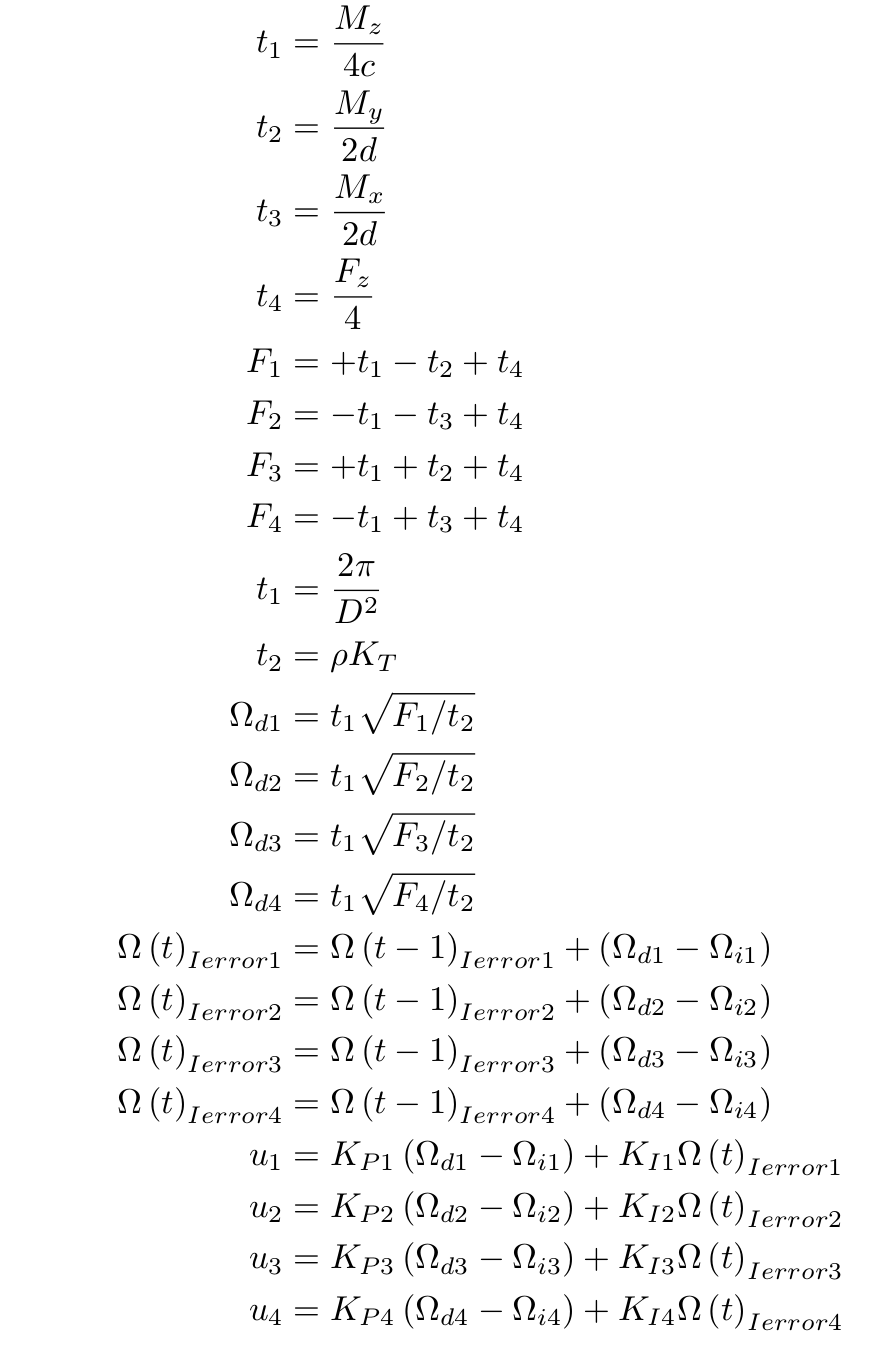
doc/figures/equations/list_motor.png
