srlm-io/anzhelka/doc/figures/equations/moment_pid.png

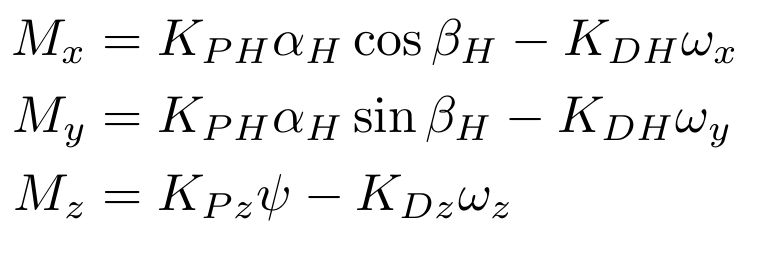
doc/figures/equations/moment_pid.png
