srlm-io/anzhelka/doc/figures/equations/quaternion_rotation.png

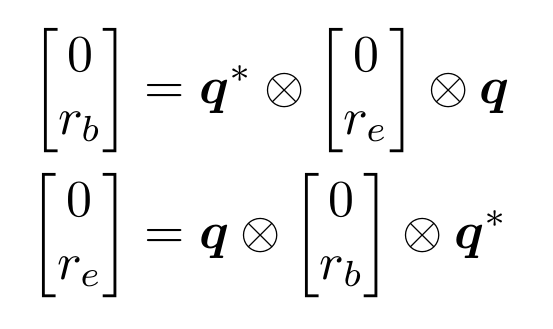
doc/figures/equations/quaternion_rotation.png
