srlm-io/anzhelka/doc/figures/equations/thrust_torque.png

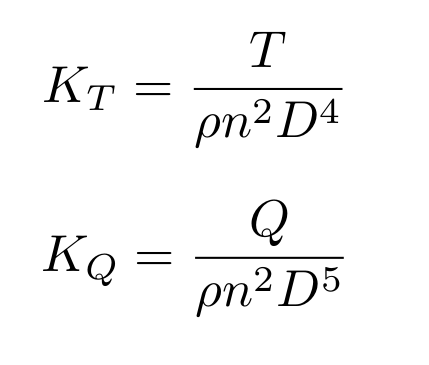
doc/figures/equations/thrust_torque.png
