srlm-io/anzhelka/doc/figures/timeline_2012_03_15.png

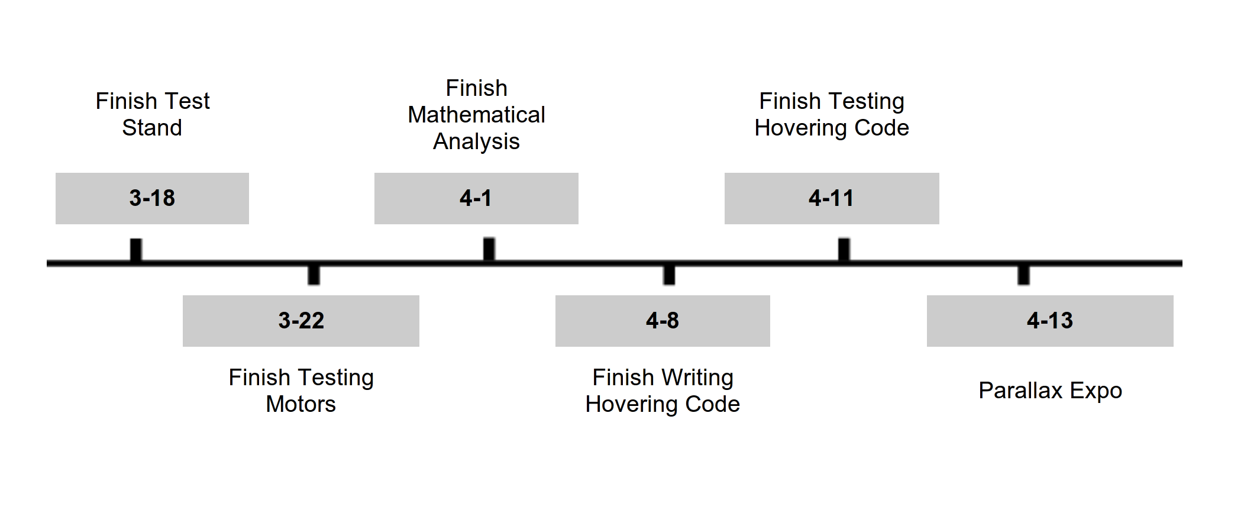
doc/figures/timeline_2012_03_15.png
