srlm-io/anzhelka/doc/figures/UM6LT_top_large.JPG

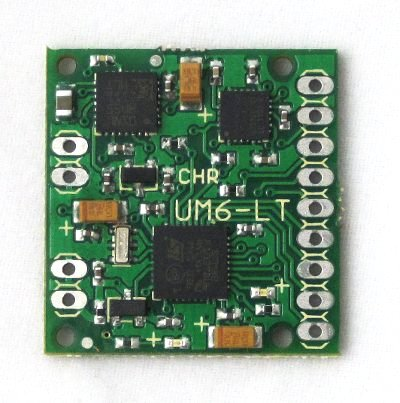
doc/figures/UM6LT_top_large.JPG
