srlm-io/anzhelka/hardware/frame/Bottom Chassis Plate.DXF

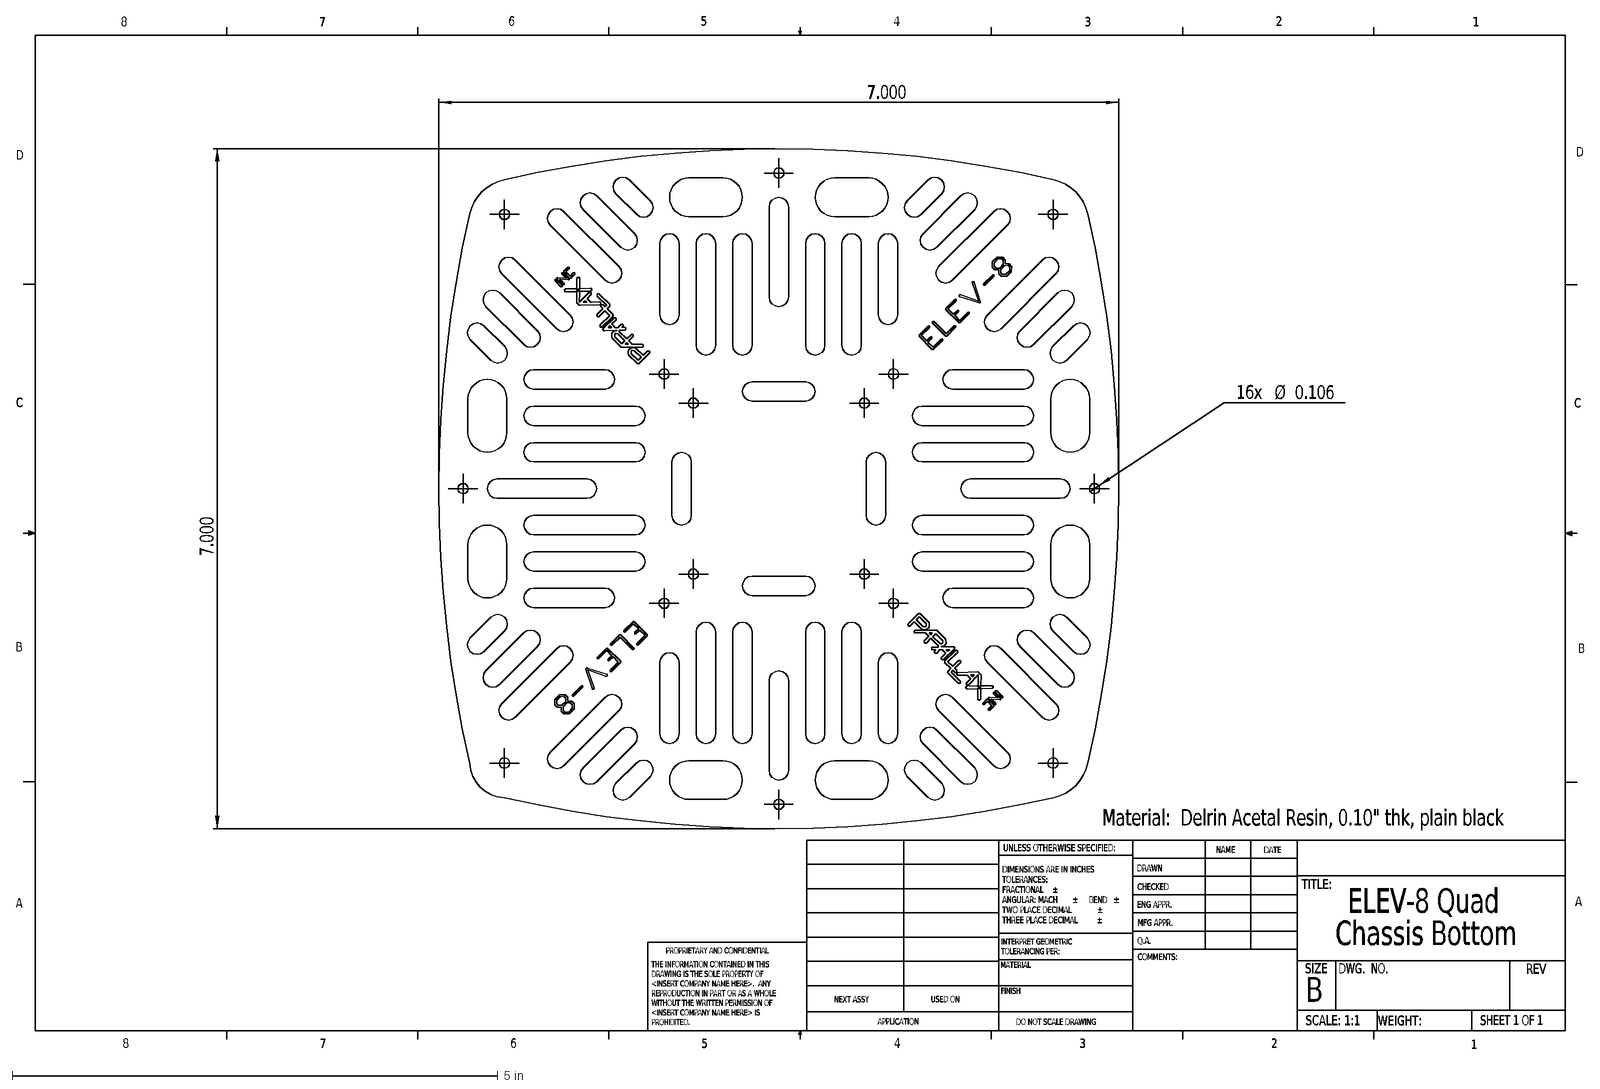
[picture p60: CAD file, 2012-01-25]
hardware/frame/Bottom Chassis Plate.DXF
Material: Delrin Acetal Resin, 0.10" thk, plain black
D
C
B
A
1
2
3
4
5
6
7
8
THE INFORMATION CONTAINED IN THIS
DRAWING IS THE SOLE PROPERTY OF
<INSERT COMPANY NAME HERE>. ANY
REPRODUCTION IN PART OR AS A WHOLE
WITHOUT THE WRITTEN PERMISSION OF
<INSERT COMPANY NAME HERE> IS
PROHIBITED.
PROPRIETARY AND CONFIDENTIAL
NEXT ASSY
USED ON
APPLICATION
DIMENSIONS ARE IN INCHES
TOLERANCES:
FRACTIONAL
±
ANGULAR: MACH
BEND
TWO PLACE DECIMAL
THREE PLACE DECIMAL
INTERPRET GEOMETRIC
TOLERANCING PER:
MATERIAL
FINISH
DRAWN
CHECKED
ENG APPR.
MFG APPR.
Q.A.
COMMENTS:
DATE
NAME
TITLE:
SIZE
DWG. NO.
REV
WEIGHT:
SCALE: 1:1
UNLESS OTHERWISE SPECIFIED:
ELEV-8 Quad
Chassis Bottom
SHEET 1 OF 1
DO NOT SCALE DRAWING
7.000
16x
Ø
0.106
