srlm-io/anzhelka/hardware/frame/Control Board Mt. Plate.DXF

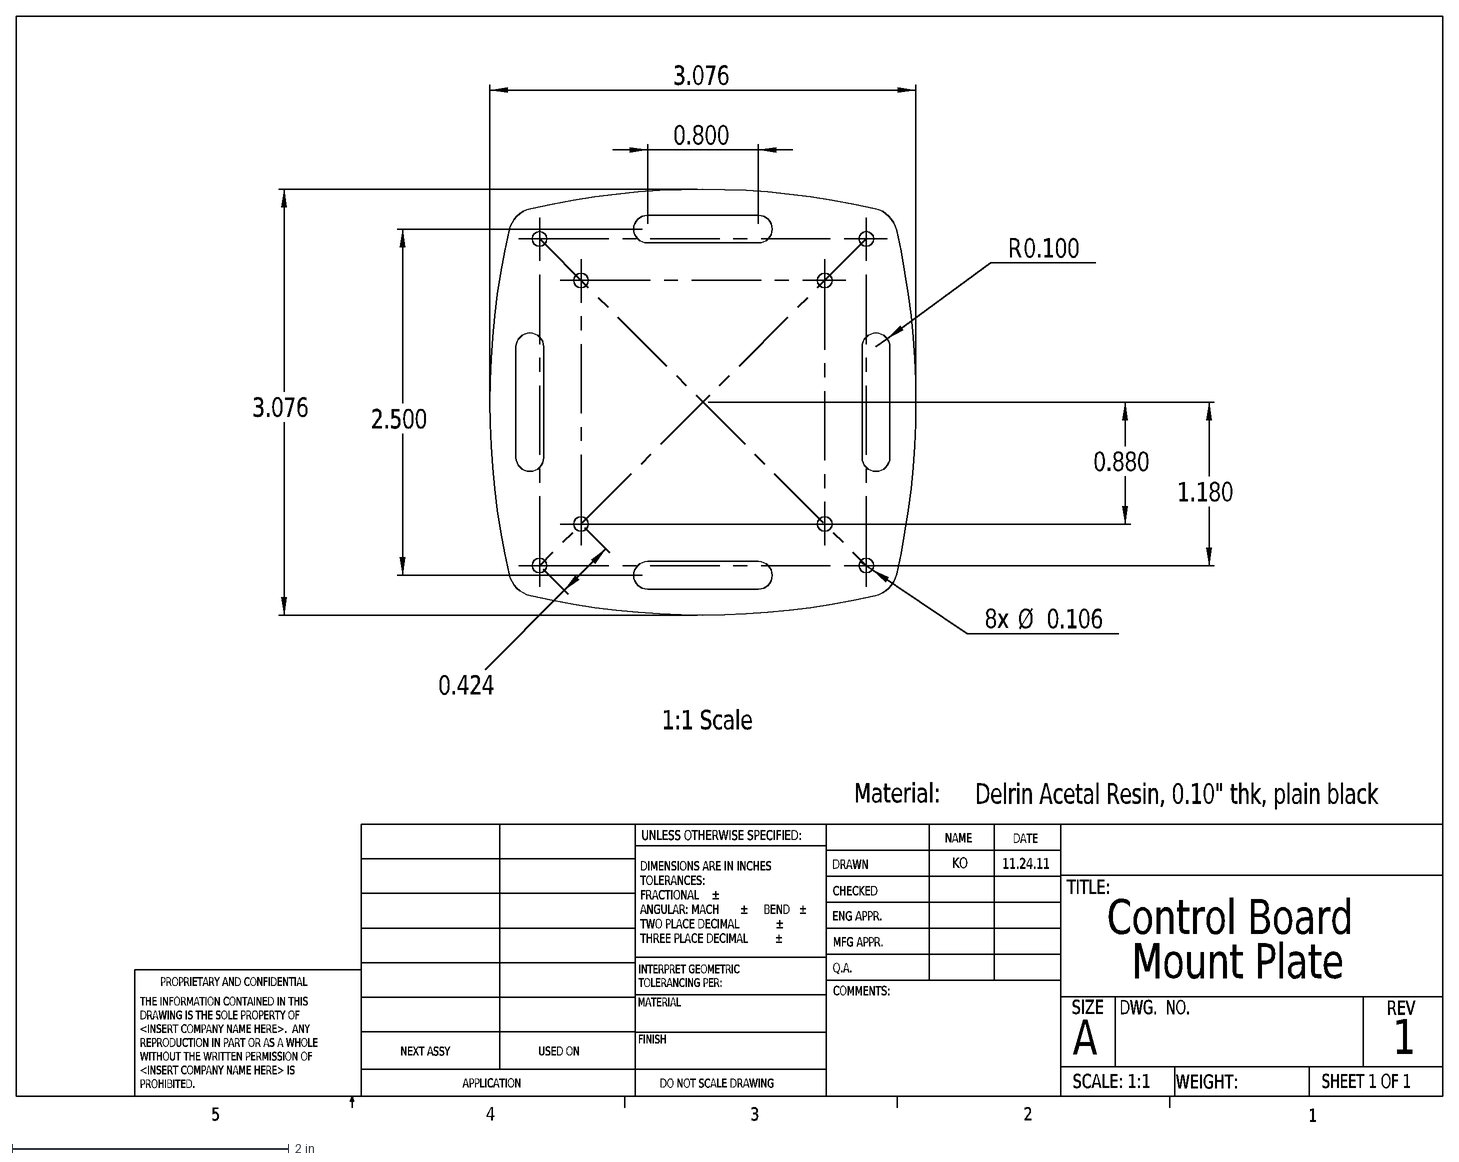
[picture p61: CAD file, 2012-01-25]
hardware/frame/Control Board Mt. Plate.DXF
Material:
Delrin Acetal Resin, 0.10" thk, plain black
1:1 Scale
1
DO NOT SCALE DRAWING
Control Board
Mount Plate
SHEET 1 OF 1
11.24.11
KO
UNLESS OTHERWISE SPECIFIED:
SCALE: 1:1
WEIGHT:
REV
DWG. NO.
A
SIZE
TITLE:
NAME
DATE
COMMENTS:
Q.A.
MFG APPR.
ENG APPR.
CHECKED
DRAWN
FINISH
MATERIAL
INTERPRET GEOMETRIC
TOLERANCING PER:
DIMENSIONS ARE IN INCHES
TOLERANCES:
FRACTIONAL
±
ANGULAR: MACH
BEND
TWO PLACE DECIMAL
THREE PLACE DECIMAL
APPLICATION
USED ON
NEXT ASSY
PROPRIETARY AND CONFIDENTIAL
THE INFORMATION CONTAINED IN THIS
DRAWING IS THE SOLE PROPERTY OF
<INSERT COMPANY NAME HERE>. ANY
REPRODUCTION IN PART OR AS A WHOLE
WITHOUT THE WRITTEN PERMISSION OF
<INSERT COMPANY NAME HERE> IS
PROHIBITED.
5
4
3
2
3.076
0.880
1.180
0.800
R
0.100
8x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
