srlm-io/anzhelka/hardware/pcb/QuadPower/REV-A/eaglesch.pdf

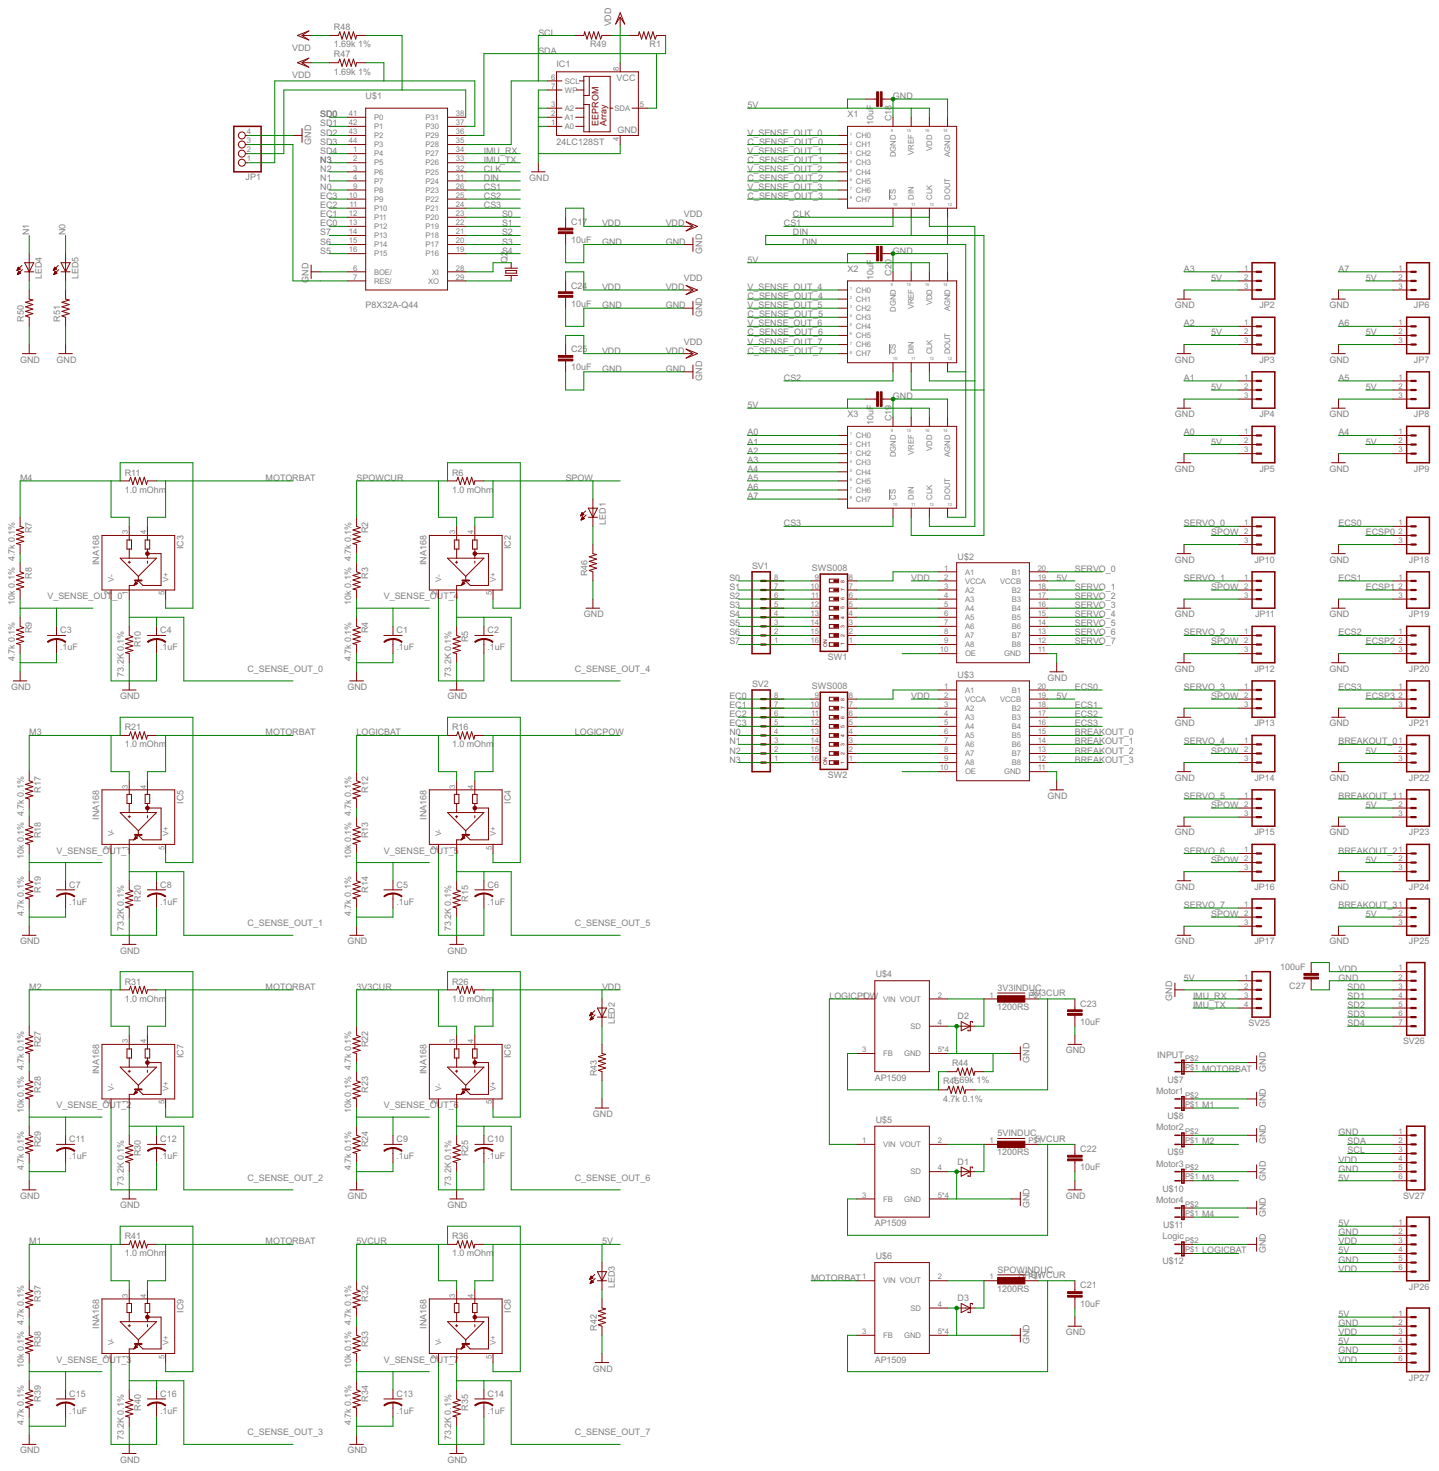
[picture p65: page 1]

GND GND

SPOW
GND GND GND GND

ECSP0 ECSP1 ECSP2 ECSP3

GND GND GND
