srlm-io/anzhelka/hardware/pcb/QuadPower/REV-A/eagleboth.pdf

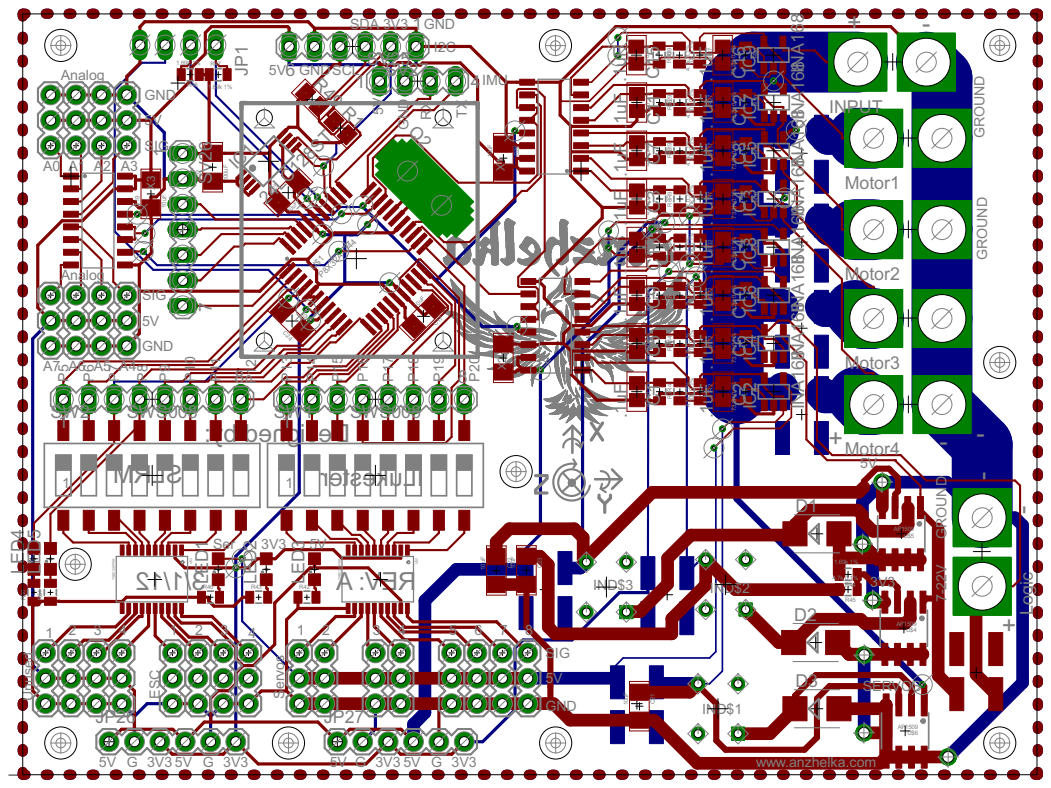
[picture p66: page 1]
