srlm-io/anzhelka/hardware/pcb/QuadPower/REV-A/eaglebottomwsilk.pdf

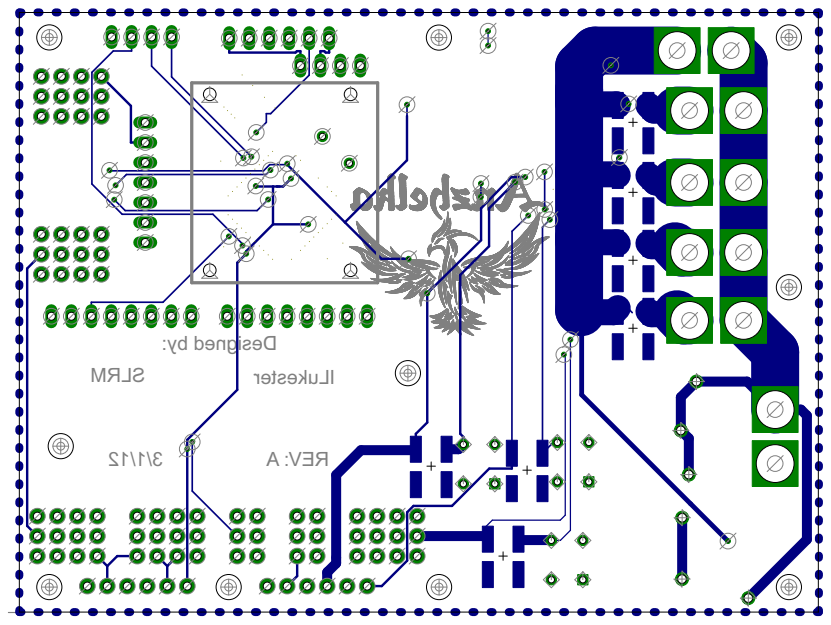
[picture p67: page 1]
