srlm-io/anzhelka/hardware/pcb/QuadPower/REV-A/eaglenone.pdf

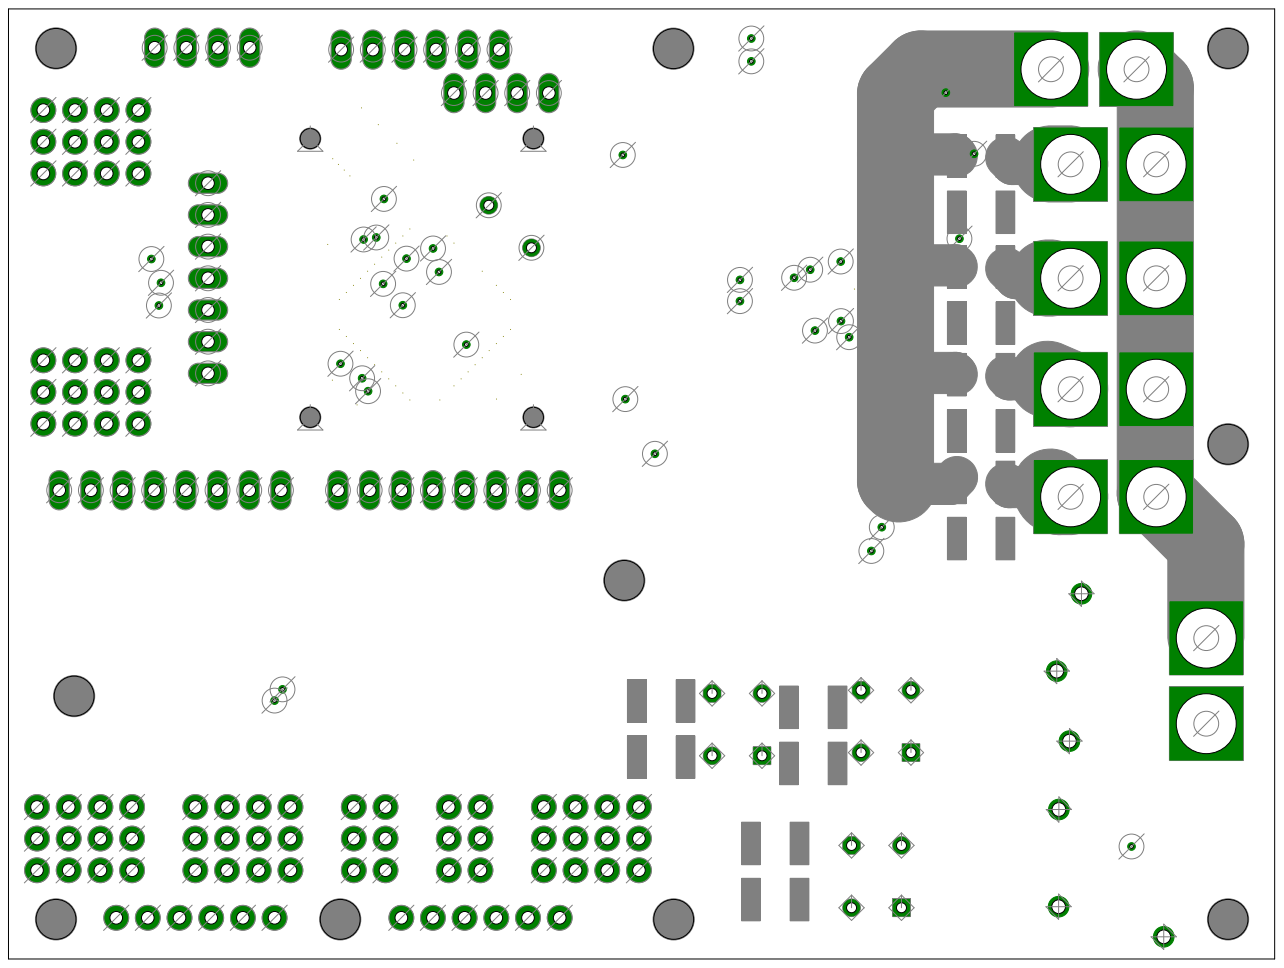
[picture p68: page 1]
