srlm-io/anzhelka/hardware/pcb/QuadPower/REV-A/eagletopwsilk.pdf

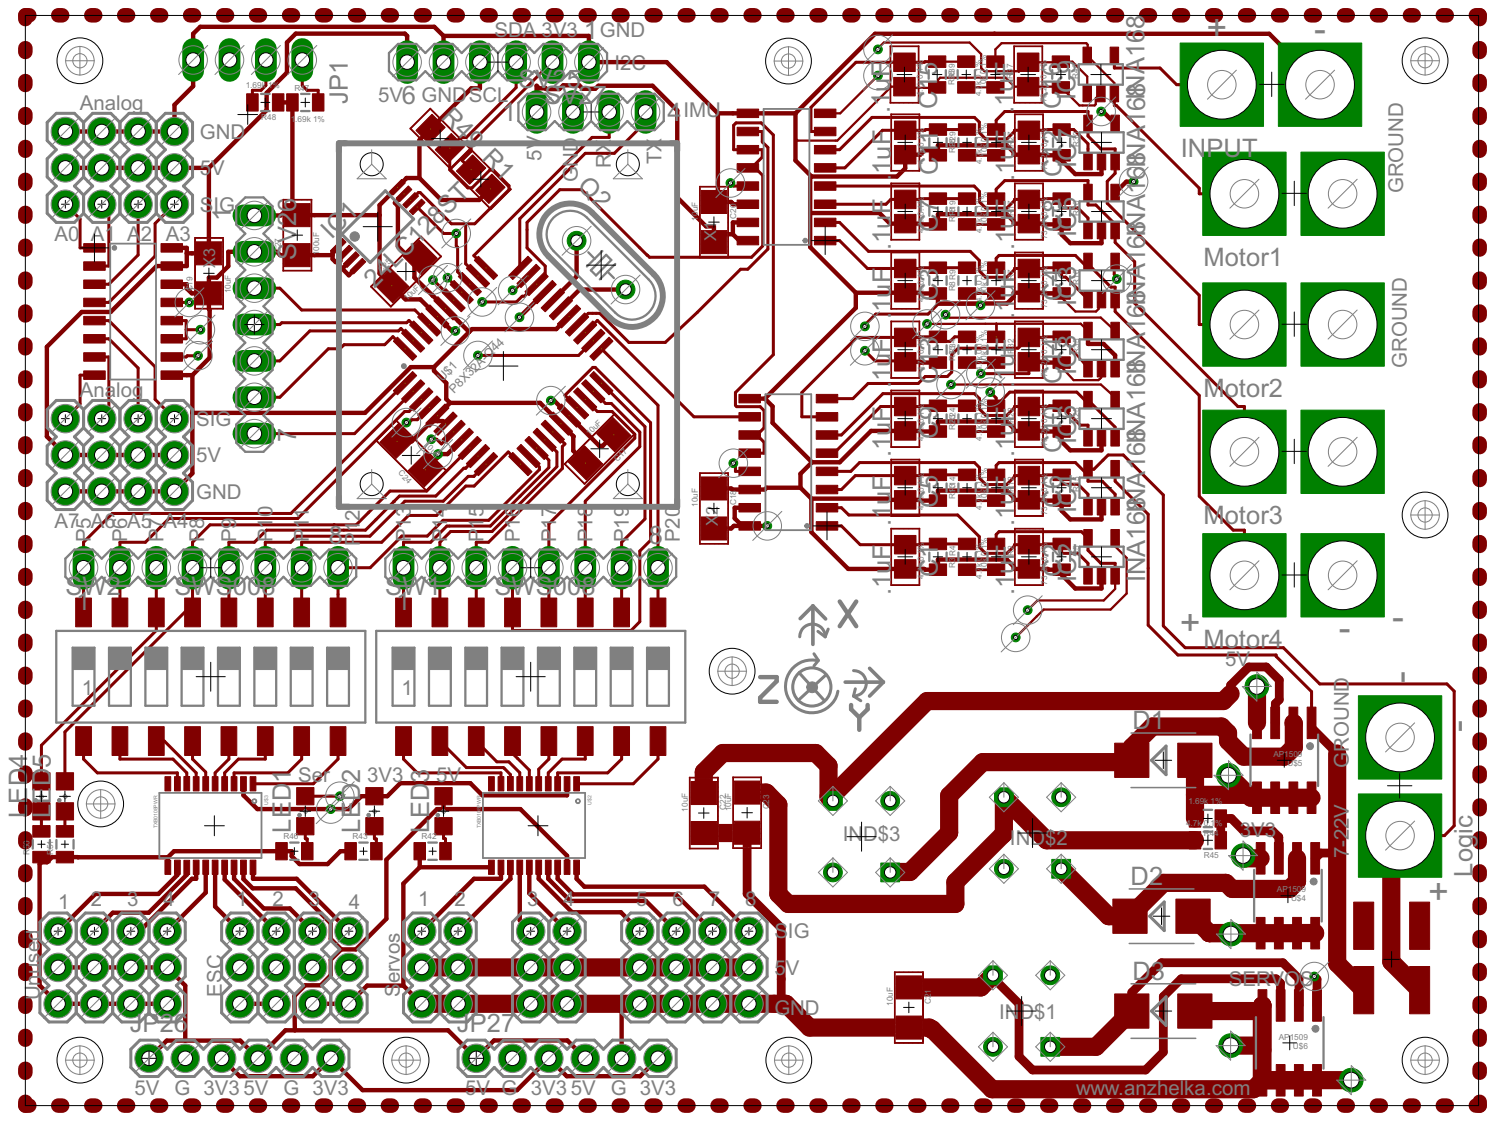
[picture p69: page 1]
