srlm-io/anzhelka/hardware/pcb/QuadPower/Current/powerattempt9wout.brd

## EAGLE design hardware/pcb/QuadPower/Current/powerattempt9wout.brd (2012-03-10)

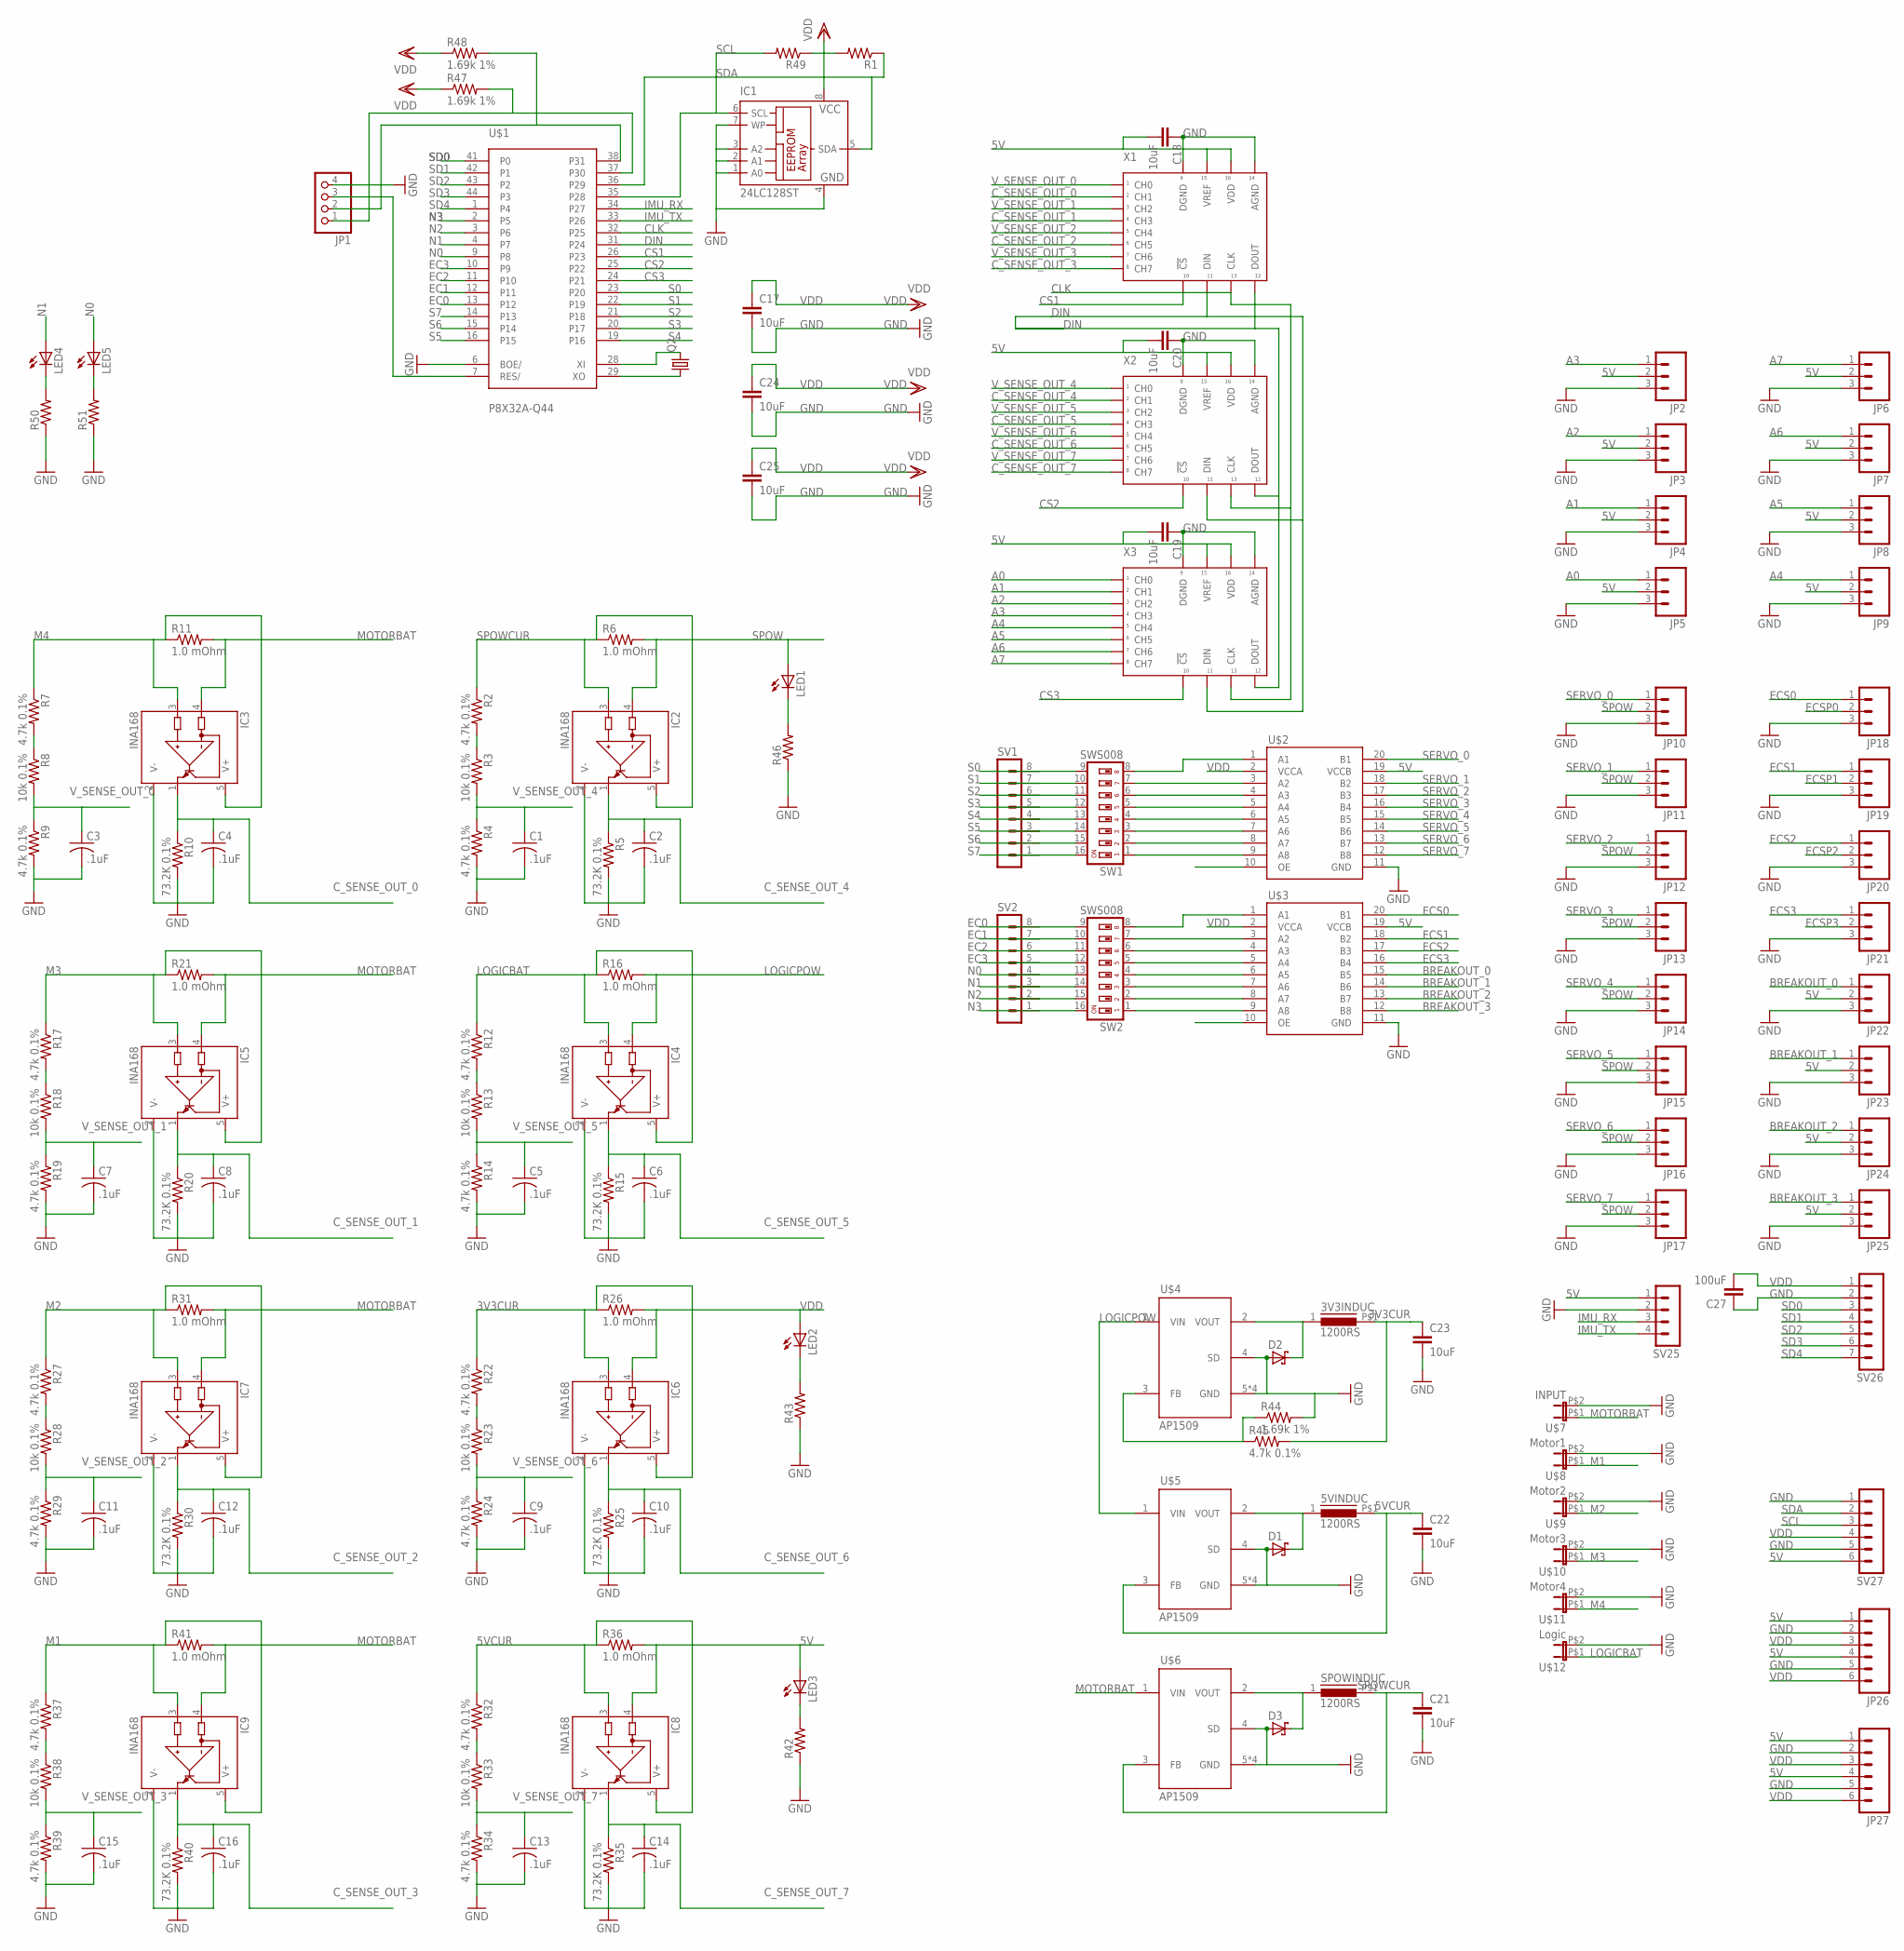
[picture p70: schematic powerattempt9wout.sch]

Parts:
3V3INDUC, 5VINDUC: 1200RS
C1, C2, C3, C4, C5, C6, C7, C8, C9, C10, C11, C12, C13, C14, C15, C16: .1uF; C0805
C17, C18, C19, C20, C21, C22, C23, C24, C25: 10uF; 1206
C27: 100uF; 1206
D1, D2, D3: SCHOTTKY-DIODESMD; SMB
IC1: 24LC128ST; TSSOP8
IC2, IC3, IC4, IC5, IC6, IC7, IC8, IC9: INA168; SOT23-5
JP1: PINHD-1X4/90; 1X04/90
JP2, JP3, JP4, JP5, JP6, JP7, JP8, JP9, JP10, JP11, JP12, JP13, JP14, JP15, JP16, JP17, JP18, JP19, JP20, JP21, JP22, JP23, JP24, JP25: M03PTH; 1X03
JP26, JP27: M06SIP; 1X06
LED1, LED2, LED3, LED4, LED5: LEDSML0805; SML0805
Q2: CRYSTALHC49S; HC49/S
R1, R49: R-US_M0805; M0805
R2, R4, R7, R9, R12, R14, R17, R19, R22, R24, R27, R29, R32, R34, R37, R39, R45: 4.7k 0.1%; 0805
R3, R8, R13, R18, R23, R28, R33, R38: 10k 0.1%; 0805
R5, R10, R15, R20, R25, R30, R35, R40: 73.2K 0.1%; 0805
R6, R11, R16, R21, R26, R31, R36, R41: 1.0 mOhm; LVK25
R42, R43, R46, R50, R51: RESISTOR0805-RES; 0805
R44, R47, R48: 1.69k 1%; 0805
SPOWINDUC: 1200RS
SV1, SV2: MA08-1
SV25: MA04-1
SV26: MA07-1
SV27: MA06-1
SW1, SW2: SWS008; SMS-008
U$1: P8X32A-Q44
U$2, U$3: TXB0108PWR; TSSOP20
U$4, U$5, U$6: AP1509; SO08
U$7: INPUT; DEANS
U$8: Motor1; DEANS
U$9: Motor2; DEANS
U$10: Motor3; DEANS
U$11: Motor4; DEANS
U$12: Logic; DEANS
X1, X2, X3: 21298ESMD; PDIP16

Connections:
3V3CUR: 3V3INDUC.P$1 (2), C23.1, IC6.3 (IN+), IC6.5 (V+), R22.1, R26.P$1 (1), R45.2
5V: C18.2, C19.2, C20.2, IC8.4 (IN-), JP2.2, JP3.2, JP4.2, JP5.2, JP6.2, JP7.2, JP8.2, JP9.2, JP22.2, JP23.2, JP24.2, JP25.2, JP26.1, JP26.4, JP27.1, JP27.4, LED3.A, R36.P$5 (2), SV25.1, SV27.6, U$2.19 (VCCB), U$3.19 (VCCB), X1.P$15 (VREF), X1.P$16 (VDD), X2.P$15 (VREF), X2.P$16 (VDD), X3.P$15 (VREF), X3.P$16 (VDD)
5VCUR: 5VINDUC.P$1 (2), C22.1, IC8.3 (IN+), IC8.5 (V+), R32.1, R36.P$1 (1), U$5.3 (FB)
A0: JP5.1, X3.P$1 (CH0)
A1: JP4.1, X3.P$2 (CH1)
A2: JP3.1, X3.P$3 (CH2)
A3: JP2.1, X3.P$4 (CH3)
A4: JP9.1, X3.P$5 (CH4)
A5: JP8.1, X3.P$6 (CH5)
A6: JP7.1, X3.P$7 (CH6)
A7: JP6.1, X3.P$8 (CH7)
BREAKOUT_0: JP22.1, U$3.15 (B5)
BREAKOUT_1: JP23.1, U$3.14 (B6)
BREAKOUT_2: JP24.1, U$3.13 (B7)
BREAKOUT_3: JP25.1, U$3.12 (B8)
CLK: U$1.32 (P25), X1.P$13 (CLK), X2.P$13 (CLK), X3.P$13 (CLK)
CS1: U$1.26 (P23), X1.P$10 (!CS)
CS2: U$1.25 (P22), X2.P$10 (!CS)
CS3: U$1.24 (P21), X3.P$10 (!CS)
C_SENSE_OUT_0: C4.1, IC3.1 (OUT), R10.1, X1.P$2 (CH1)
C_SENSE_OUT_1: C8.1, IC5.1 (OUT), R20.1, X1.P$4 (CH3)
C_SENSE_OUT_2: C12.1, IC7.1 (OUT), R30.1, X1.P$6 (CH5)
C_SENSE_OUT_3: C16.1, IC9.1 (OUT), R40.1, X1.P$8 (CH7)
C_SENSE_OUT_4: C2.1, IC2.1 (OUT), R5.1, X2.P$2 (CH1)
C_SENSE_OUT_5: C6.1, IC4.1 (OUT), R15.1, X2.P$4 (CH3)
C_SENSE_OUT_6: C10.1, IC6.1 (OUT), R25.1, X2.P$6 (CH5)
C_SENSE_OUT_7: C14.1, IC8.1 (OUT), R35.1, X2.P$8 (CH7)
DIN: U$1.31 (P24), X1.P$11 (DIN), X1.P$12 (DOUT), X2.P$11 (DIN), X2.P$12 (DOUT), X3.P$11 (DIN), X3.P$12 (DOUT)
EC0: SV2.8, SW2.9, U$1.13 (P12)
EC1: SV2.7, SW2.10, U$1.12 (P11)
EC2: SV2.6, SW2.11, U$1.11 (P10)
EC3: SV2.5, SW2.12, U$1.10 (P9)
ECS0: JP18.1, U$3.20 (B1)
ECS1: JP19.1, U$3.18 (B2)
ECS2: JP20.1, U$3.17 (B3)
ECS3: JP21.1, U$3.16 (B4)
ECSP0: JP18.2
ECSP1: JP19.2
ECSP2: JP20.2
ECSP3: JP21.2
GND: C1.2, C2.2, C3.2, C4.2, C5.2, C6.2, C7.2, C8.2, C9.2, C10.2, C11.2, C12.2, C13.2, C14.2, C15.2, C16.2, C17.2, C18.1, C19.1, C20.1, C21.2, C22.2, C23.2, C24.2, C25.2, C27.1, D1.A, D2.A, D3.A, IC1.1 (A0), IC1.2 (A1), IC1.3 (A2), IC1.4 (GND), IC1.7 (WP), IC2.2 (V-), IC3.2 (V-), IC4.2 (V-), IC5.2 (V-), IC6.2 (V-), IC7.2 (V-), IC8.2 (V-), IC9.2 (V-), JP1.4, JP2.3, JP3.3, JP4.3, JP5.3, JP6.3, JP7.3, JP8.3, JP9.3, JP10.3, JP11.3, JP12.3, JP13.3, JP14.3, JP15.3, JP16.3, JP17.3, JP18.3, JP19.3, JP20.3, JP21.3, JP22.3, JP23.3, JP24.3, JP25.3, JP26.2, JP26.5, JP27.2, JP27.5, R4.2, R5.2, R9.2, R10.2, R14.2, R15.2, R19.2, R20.2, R24.2, R25.2, R29.2, R30.2, R34.2, R35.2, R39.2, R40.2, R42.1, R43.1, R44.2, R46.1, R50.1, R51.1, SV25.2, SV26.2, SV27.1, SV27.5, U$1.5 (GND), U$1.6 (BOE/), U$1.17 (GND), U$1.27 (GND), U$1.39 (GND), U$2.11 (GND), U$3.11 (GND), U$4.4 (SD), U$4.5 (GND), U$4.6 (GND), U$4.7 (GND), U$4.8 (GND), U$5.4 (SD), U$5.5 (GND), U$5.6 (GND), U$5.7 (GND), U$5.8 (GND), U$6.4 (SD), U$6.5 (GND), U$6.6 (GND), U$6.7 (GND), U$6.8 (GND), U$7.P$2 (2), U$8.P$2 (2), U$9.P$2 (2), U$10.P$2 (2), U$11.P$2 (2), U$12.P$2 (2), X1.P$9 (DGND), X1.P$14 (AGND), X2.P$9 (DGND), X2.P$14 (AGND), X3.P$9 (DGND), X3.P$14 (AGND)
IMU_RX: SV25.3, U$1.34 (P27)
IMU_TX: SV25.4, U$1.33 (P26)
LOGICBAT: IC4.3 (IN+), IC4.5 (V+), R12.1, R16.P$1 (1), U$12.P$1 (1)
LOGICPOW: IC4.4 (IN-), R16.P$5 (2), U$4.1 (VIN), U$5.1 (VIN)
M1: IC9.3 (IN+), IC9.5 (V+), R37.1, R41.P$1 (1), U$8.P$1 (1)
M2: IC7.3 (IN+), IC7.5 (V+), R27.1, R31.P$1 (1), U$9.P$1 (1)
M3: IC5.3 (IN+), IC5.5 (V+), R17.1, R21.P$1 (1), U$10.P$1 (1)
M4: IC3.3 (IN+), IC3.5 (V+), R7.1, R11.P$1 (1), U$11.P$1 (1)
MOTORBAT: IC3.4 (IN-), IC5.4 (IN-), IC7.4 (IN-), IC9.4 (IN-), R11.P$5 (2), R21.P$5 (2), R31.P$5 (2), R41.P$5 (2), U$6.1 (VIN), U$7.P$1 (1)
N0: LED5.A, SV2.4, SW2.13, U$1.9 (P8)
N1: LED4.A, SV2.3, SW2.14, U$1.4 (P7)
N2: SV2.2, SW2.15, U$1.3 (P6)
N3: SV2.1, SW2.16, U$1.2 (P5)
unnamed: JP1.1, R47.2, U$1.37 (P30)
unnamed: JP1.2, R48.2, U$1.38 (P31)
unnamed: LED4.C, R50.2
unnamed: LED5.C, R51.2
unnamed: Q2.1, U$1.29 (XO)
unnamed: Q2.2, U$1.28 (XI)
unnamed: JP1.3, U$1.7 (RES/)
unnamed: R2.2, R3.1
unnamed: R7.2, R8.1
unnamed: R12.2, R13.1
unnamed: R17.2, R18.1
unnamed: R22.2, R23.1
unnamed: R27.2, R28.1
unnamed: R32.2, R33.1
unnamed: R37.2, R38.1
unnamed: SW1.8, U$2.1 (A1)
unnamed: SW1.7, U$2.3 (A2)
unnamed: SW1.6, U$2.4 (A3)
unnamed: SW1.5, U$2.5 (A4)
unnamed: SW1.4, U$2.6 (A5)
unnamed: SW1.3, U$2.7 (A6)
unnamed: SW1.2, U$2.8 (A7)
unnamed: SW1.1, U$2.9 (A8)
unnamed: SW2.8, U$3.1 (A1)
unnamed: SW2.7, U$3.3 (A2)
unnamed: SW2.6, U$3.4 (A3)
unnamed: SW2.5, U$3.5 (A4)
unnamed: SW2.4, U$3.6 (A5)
unnamed: SW2.3, U$3.7 (A6)
unnamed: SW2.2, U$3.8 (A7)
unnamed: SW2.1, U$3.9 (A8)
unnamed: LED1.C, R46.2
unnamed: LED2.C, R43.2
unnamed: LED3.C, R42.2
unnamed: 3V3INDUC.1, D2.C, U$4.2 (VOUT)
unnamed: 5VINDUC.1, D1.C, U$5.2 (VOUT)
unnamed: D3.C, SPOWINDUC.1, U$6.2 (VOUT)
unnamed: R44.1, R45.1, U$4.3 (FB)
S0: SV1.8, SW1.9, U$1.23 (P20)
S1: SV1.7, SW1.10, U$1.22 (P19)
S2: SV1.6, SW1.11, U$1.21 (P18)
S3: SV1.5, SW1.12, U$1.20 (P17)
S4: SV1.4, SW1.13, U$1.19 (P16)
S5: SV1.3, SW1.14, U$1.16 (P15)
S6: SV1.2, SW1.15, U$1.15 (P14)
S7: SV1.1, SW1.16, U$1.14 (P13)
SCL: IC1.6 (SCL), R49.2, SV27.3, U$1.35 (P28)
SD0: SV26.3, U$1.41 (P0)
SD1: SV26.4, U$1.42 (P1)
SD2: SV26.5, U$1.43 (P2)
SD3: SV26.6, U$1.44 (P3)
SD4: SV26.7, U$1.1 (P4)
SDA: IC1.5 (SDA), R1.1, SV27.2, U$1.36 (P29)
SERVO_0: JP10.1, U$2.20 (B1)
SERVO_1: JP11.1, U$2.18 (B2)
SERVO_2: JP12.1, U$2.17 (B3)
SERVO_3: JP13.1, U$2.16 (B4)
SERVO_4: JP14.1, U$2.15 (B5)
SERVO_5: JP15.1, U$2.14 (B6)
SERVO_6: JP16.1, U$2.13 (B7)
SERVO_7: JP17.1, U$2.12 (B8)
SPOW: IC2.4 (IN-), JP10.2, JP11.2, JP12.2, JP13.2, JP14.2, JP15.2, JP16.2, JP17.2, LED1.A, R6.P$5 (2)
SPOWCUR: C21.1, IC2.3 (IN+), IC2.5 (V+), R2.1, R6.P$1 (1), SPOWINDUC.P$1 (2), U$6.3 (FB)
VDD: C17.1, C24.1, C25.1, C27.2, IC1.8 (VCC), IC6.4 (IN-), JP26.3, JP26.6, JP27.3, JP27.6, LED2.A, R1.2, R26.P$5 (2), R47.1, R48.1, R49.1, SV26.1, SV27.4, U$1.8 (VDD), U$1.18 (VDD), U$1.30 (VDD), U$1.40 (VDD), U$2.2 (VCCA), U$3.2 (VCCA)
V_SENSE_OUT_0: C3.1, R8.2, R9.1, X1.P$1 (CH0)
V_SENSE_OUT_1: C7.1, R18.2, R19.1, X1.P$3 (CH2)
V_SENSE_OUT_2: C11.1, R28.2, R29.1, X1.P$5 (CH4)
V_SENSE_OUT_3: C15.1, R38.2, R39.1, X1.P$7 (CH6)
V_SENSE_OUT_4: C1.1, R3.2, R4.1, X2.P$1 (CH0)
V_SENSE_OUT_5: C5.1, R13.2, R14.1, X2.P$3 (CH2)
V_SENSE_OUT_6: C9.1, R23.2, R24.1, X2.P$5 (CH4)
V_SENSE_OUT_7: C13.1, R33.2, R34.1, X2.P$7 (CH6)

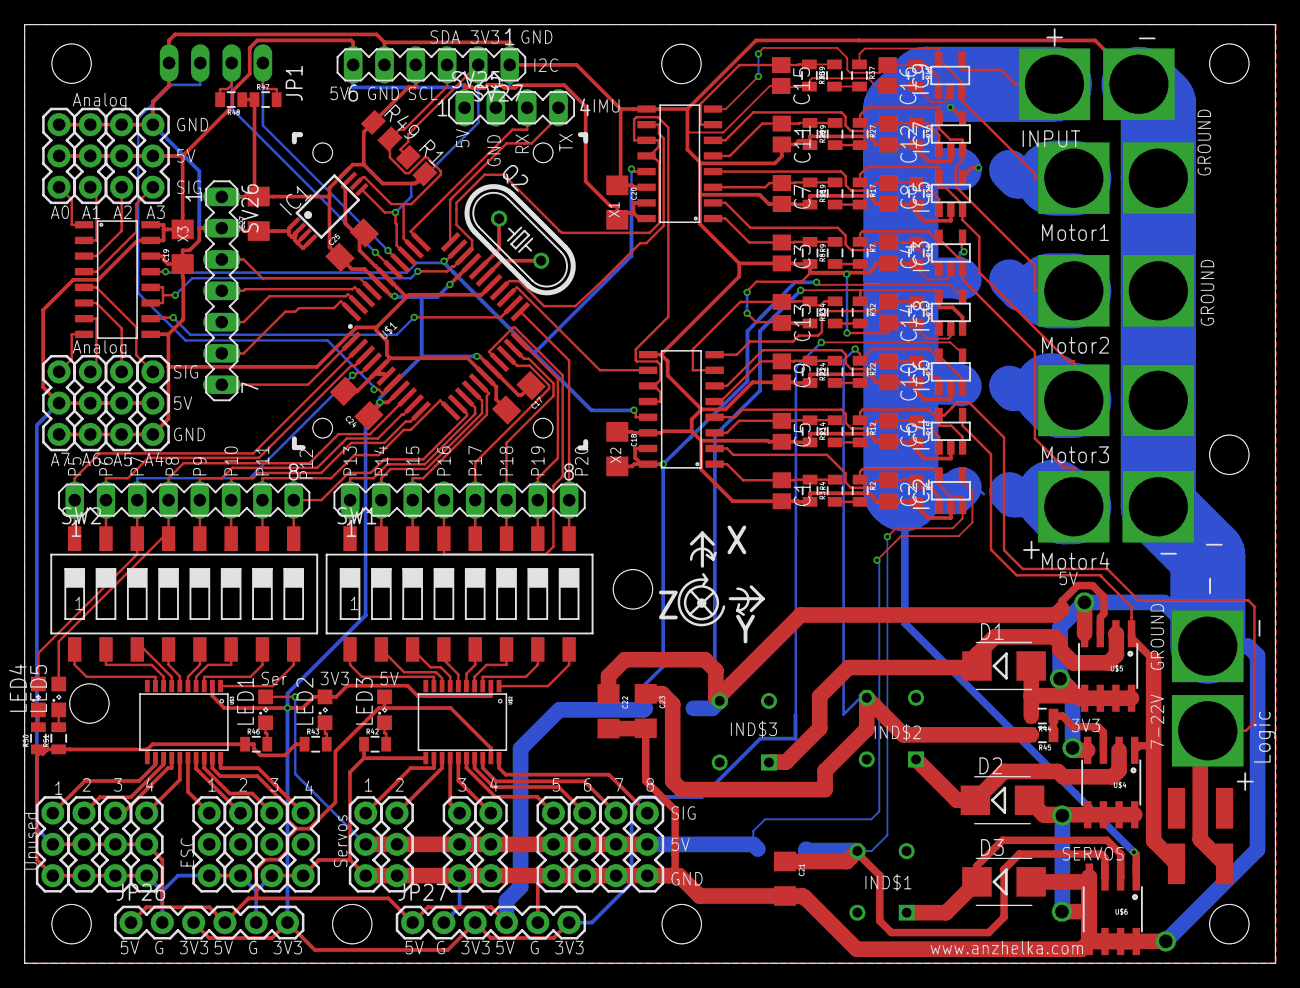
[picture p71: board powerattempt9wout.brd from above]

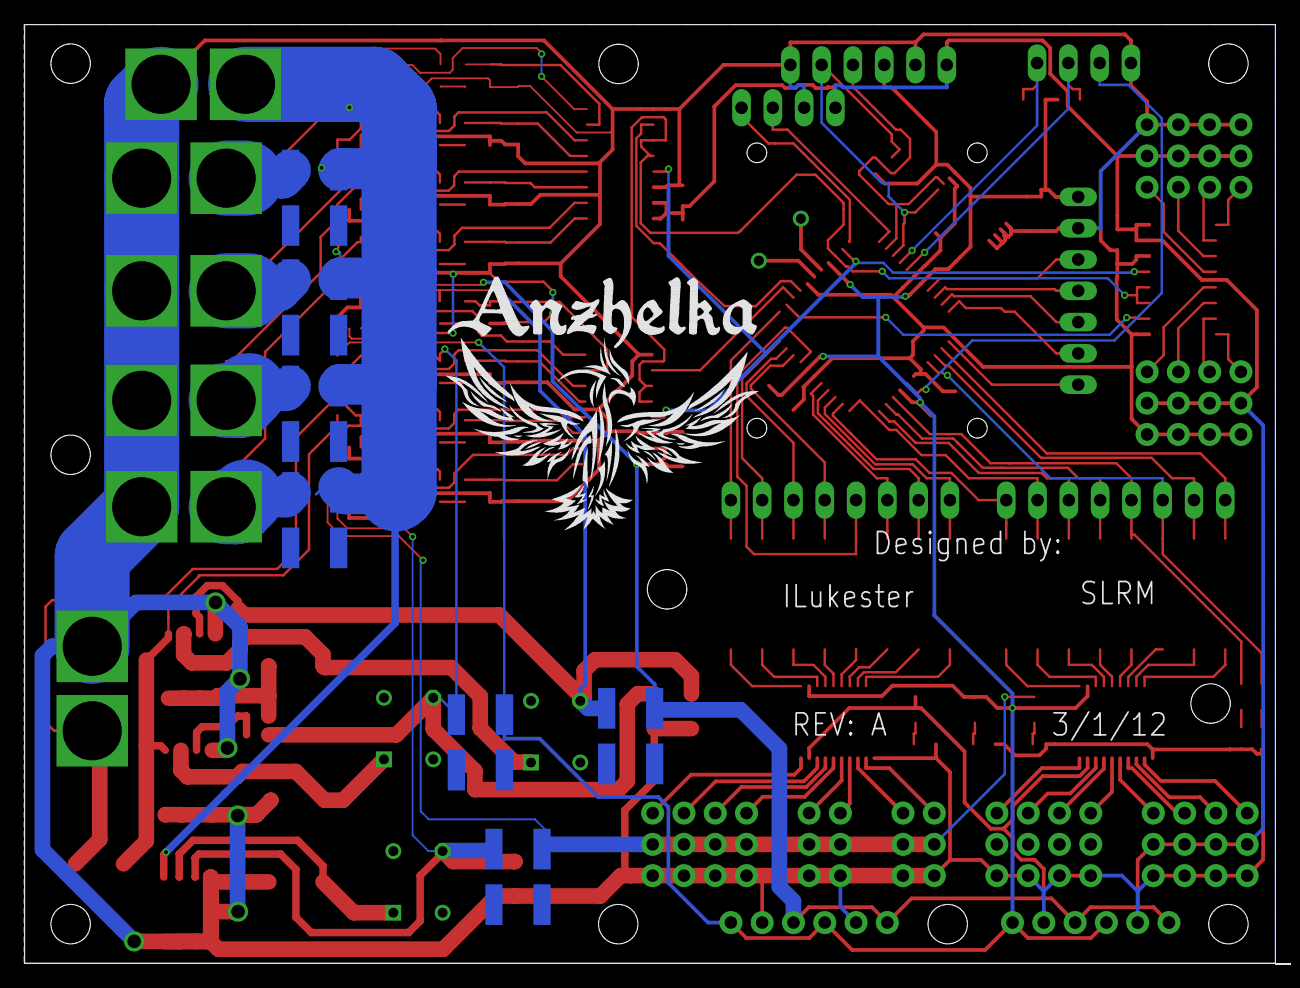
[picture p72: board powerattempt9wout.brd from below]

Board: 2 copper layers, 101.5 x 76.2 mm, 147 parts (7 on the bottom side), 122 nets.
