srlm-io/anzhelka/extra/test_stand/test_stand.spin

{{
--------------------------------------------------------------------------------
Anzhelka Project
(c) 2012

For the latest code and support, please visit:
http://code.anzhelka.com
--------------------------------------------------------------------------------

Title: Test Stand
Author: Cody Lewis (SRLM)
Date: 3-24-2012
Notes: This software automatically runs the test stand.



}}
CON
	_clkmode = xtal1 + pll16x
	_xinfreq = 5_000_000

'IO Pins
	DEBUG_TX_PIN  = 30
	DEBUG_RX_PIN  = 31
	
	CLOCK_PIN = 23 'Unconnected to anything else
	
	
	ADC_D_PIN = 11
	ADC_S_PIN = 10
	ADC_C_PIN = 12
	
'	KEYPAD_LOW_PIN  = 0
'	KEYPAD_HIGH_PIN = 7
	
	ESC_PIN = 9 'turns on at ~1600 us
	
	RPM_PIN = 5 'Note: currently not used in code (a pin mask is used instead)
	
'Settings
	NUM_MOT = 4
	

	'Motor PID loop types of errors:
	CURRENT = 0
	ACCUMULATOR = 1
	PREVIOUS = 2
	DELTA = 3
	
	
'ADC Channel Names
	ADC_THRUST = 1
	ADC_TORQUE = 0
	
	
	

VAR
	long motorrps[NUM_MOT]
	long motorvolt[NUM_MOT]
	long motoramp[NUM_MOT]
	long motorpwm[NUM_MOT]
	long motorthrust[NUM_MOT]
	long motortorque[NUM_MOT]
	long motordesiredrps[NUM_MOT]

	long pid_output
	
	long pid_base_address_temp

OBJ
'	debug : "FullDuplexSerialPlus.spin"

	adc 	:	"MCP3208_fast.spin"
	pwm 	:	"PWM_32_v4.spin"
	rpm 	:	"Eagle_Tree_Brushless_RPM.spin"
'	keypad 	:	"Matrix_Membrane_Keypad.spin"
	

PUB Main | i, pwmoutput, loop_time, t1, t2, remaining_time


	InitFunctions
'	Init_Instructions
	
	n_1 := float(0)
	n_d_1 := float(0)

	fp.InitializePID(PID_n_1.getBase, @n_1, @pid_output, @n_d_1, fp.FSub(float(0), float(300)), float(300), fp.FDiv(float(1), float(50)))
	fp.SetTunings(PID_n_1.getBase, float(1), float(0), float(0))
	
'	adc.start(ADC_D_PIN, ADC_C_PIN, ADC_S_PIN, 0)
	pwm.start
'	rpm.setpins(%0001_0000_0000) 'RPM_PIN
	rpm.setpins(%0000_0010_0000) 'RPM_PIN
	rpm.start
	
	pwm.servo(ESC_PIN, 1000)

	repeat i from 2 to 0
		waitcnt(clkfreq + cnt)
		serial.str(string("$ADSTR "))
		serial.dec(phsb)
		serial.str(string(",'t minus "))
		serial.dec(i)
		serial.tx("'")
		serial.tx(10)
		serial.tx(13)
	
	pwm.servo(ESC_PIN, 1300)
	waitcnt(clkfreq * 1 + cnt)

			
	i := 90
	n_d_1 := fp.FFloat(i)
	
	loop_time := clkfreq/50

	repeat
		t1 := cnt
		loop(i)
		ParseSerial
		PrintArrayAddr4(string("NIM"), @n_1, @n_2, @n_3, @n_4, TYPE_FLOAT)
'		PrintArrayAddr4(string("PWM"), @u_1, @u_2, @u_3, @u_4, TYPE_FLOAT)	

		t1 := cnt - t1

		remaining_time := loop_time - t1 - 100_000
		if remaining_time > 0
			waitcnt(remaining_time + cnt)
		else
			PrintStr(string("Missed Timing Period! ***********************"))

PUB loop(i)
	n_1 := fp.FFloat( 0 #> rpm.getrps(0) <# 250) 'Min < rps < Max

	fp.FPID(PID_n_1.getBase)
	
		
'	fp.FInterpret(@CONTROL_LOOP_INSTRUCTIONS)

'	Follows this equation:
	'rpm = (max_rpm - y_intercept)/(pwm@max_rpm) * pwm + y_intercept

'	u_1 := fp.FMul(slope, n_d_1)
'	u_1 := fp.FSub(u_1, intercept)
	u_1 := fp.FAdd(n_d_1, motor_intercept)
	u_1 := fp.FDiv(u_1, motor_slope)
'	u_1 := fp.FAdd(u_1, MIN_PWM)
	u_1 := fp.FAdd(u_1, pid_output)
	u_1 := fp.FLimitMin(u_1, MIN_PWM)
	u_1 := fp.FLimitMax(u_1, MAX_PWM)


	pwm.servo(ESC_PIN, fp.FTrunc(u_1))

PUB readForce | thrust, torque
	torque := ADC.average(ADC_TORQUE, 4)
	thrust := ADC.average(ADC_THRUST, 4)
	
	motorthrust[0] := thrust
	motortorque[0] := torque






{{AZM_MATH CONTROL_LOOP

t_1 = pid_base_address_temp ~ 0

}}
	
{{
--------------------------------------------------------------------------------  
Copyright (c) 2012 Cody Lewis and Luke De Ruyter

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
THE SOFTWARE IS PROVIDED "AS IS", WITHOUT WARRANTY OF ANY KIND, EXPRESS OR
IMPLIED, INCLUDING BUT NOT LIMITED TO THE WARRANTIES OF MERCHANTABILITY, FITNESS
FOR A PARTICULAR PURPOSE AND NONINFRINGEMENT. IN NO EVENT SHALL THE AUTHORS OR
COPYRIGHT HOLDERS BE LIABLE FOR ANY CLAIM, DAMAGES OR OTHER LIABILITY, WHETHER
IN AN ACTION OF CONTRACT, TORT OR OTHERWISE, ARISING FROM, OUT OF OR IN
CONNECTION WITH THE SOFTWARE OR THE USE OR OTHER DEALINGS IN THE SOFTWARE.
--------------------------------------------------------------------------------
}}
