srlm-io/anzhelka/(commit log)

2012-01-31 File cleanup
    [power.brd, power.sch]
2012-01-31 Almost all parts on single layer, currently will auto route without problems
    Reorganized pcbs files into directory.
    [power.brd, power.sch]
2012-03-09 Started work on the Python desktop terminal client
    Added the first CHR UM6 code, created a template script for compiling
    Updated the CHR_UM6 imu code, and added a generic spin template
    updated something (but I don't remember what)
2012-03-10 Added REV-A and the current QuadPower Boards, removed old files
    [power.brd, power.sch, powerattempt9wout.brd, powerattempt9wout.sch]
2012-03-26 Began work on Test Stand code, added motor test results, added brushless rpm sensors
2012-04-05 Completed preliminary math analysis, worked some on IMU code.
2012-04-12 Updated Python Terminal GUI, created expo trifold text, updated serial driver. The Python terminal GUI can now has a working motors tab. This tab can be used to display the relevant aspects of each m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
2012-05-01 Developed workflow for assembly debugging, namely bstc *.list file assembly output list display.
2012-05-03 Updated compile script to have listgrep, updated listgrep to work correctly for the first object in the list file. Added interesting rampings to the test_stand.
    [test_stand.spin]
2012-05-14 First initial working version of UM6 interface object. Still needs work, but will accurately filter the incomming strings. Anything that can't be filtered gets put into a buffer for reading via stand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
2012-05-17 Created the motor block, updated the compile script, fixed a few bugs in the spin.lang syntax highlighting.
2012-05-24 Created the math compiler, implemented floating point routines and tests, completed initial work on motor and moment blocks
2012-05-27 worked on PID loop. Note: this build is incomplete, fails testing.
    [block_test_harness.spin]
2012-05-28 Finished PID control loop F32_CMD block. 12 longs free.
2012-05-30 Updated serial port options. There may still be some programs that use the 4port object. Those need to switch to FastFDSBuffer. Created an anzhelka terminal test program to send 'random' strings. Did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
2012-06-02 I have updated the terminal so that it now accepts 2 way Serial. To send a command just type into the main display box in Motors -> Vars. Press Update to send the command. Besure to enter your correc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
    [anzhelka_terminal_gui_extra.py, anzhelka_terminal_serial.py]
2012-06-02 fixed bug where if no data is received it's a constant stream of errors. See diff
    [anzhelka_terminal_gui_extra.py]
2012-06-02 Test stand PID now works, suitable for testing with the terminal program. Need to find the PID constants.
2012-06-03 Add true selection functionality to the Anzhelka Termainal under the Motors -> Vars tab
2012-06-03 Worked on making the terminal bug free.
    [anzhelka_terminal_gui_extra.py, anzhelka_terminal_serial.py, anzhelka_terminal_test.spin, test_stand.spin]
2012-06-04 Fixed whacky order on Linux for dropdown boxes, Now has graph options for X length and var to be graphed, pressing enter in a value box sends the update string for said box, update all button work
    [anzhelka_terminal_gui_extra.py, anzhelka_terminal_serial.py]
2012-06-04 Fixed problems with terminal
    [anzhelka_terminal_gui_extra.py, anzhelka_terminal_serial.py]
2012-06-05 Fixed 1 being sent on connect. I believe that PWM now properly sends. Newline char is now sent after transimission. NID is now sending the proper var.
    [anzhelka_terminal_gui_extra.py, anzhelka_terminal_serial.py]
2012-06-05 Fixed Min sliderbox bug. Separate lookup table for selecting the Variable to change. StopAll is tested and working on linux and windows. You can now set default items to be graphed or loaded into var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
    [anzhelka_terminal_gui_extra.py]
2012-06-06 Anzhelka terminal now has: A title, Editable Upper and Lower bounds, Box2Slider now button is now named Defaults and resets the slider to the default position, there is now a default position placeme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
    [anzhelka_terminal_gui_extra.py]
2012-06-07 Added new variables. When you click on the Motors->Angles tab the graphing options change to angle graph options, when you click back on another tab it will show the original graphing options. Added 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
2012-06-08 Final attempt, not working...
    [anzhelka_support_functions.spin, main.spin, main_output.spin]
